Khalil-ee/MK.2-Flight-Controller/Altium/README

Schematic versions as we progress in this folder.
