Khalil-ee/MK.2-Flight-Controller/SDP_Project_Proposal_MGeorgiev_KMallory_KYacob_S2026.docx

MORGAN STATE UNIVERSITY

CLARENCE M. MITCHELL, JR. SCHOOL OF ENGINEERING

DEPARTMENT OF ELECTRICAL AND COMPUTER ENGINEERING

EEGR490

Senior Design Project Ι

Spring 2026

Project Proposal

Hybrid Flight Control System for Unmanned Aerial Vehicles

Project Members: Mitko Georgiev, Khalil Mallory, Kaleb Yacob

Project Advisor: Dr. Idris Somoye

2 April 2026

Table of Contents

Project Abstract .......................................................................................................................... 3

Identification & Significance of the Problem ............................................................................ 3

Technical Objectives ................................................................................................................. 4

Project Plan & Schedule ............................................................................................................ 4

Trade-Offs .................................................................................................................................. 8

Qualifications ............................................................................................................................. 10

Facilities/Equipment .................................................................................................................. 10

Budget ...................................................................................................................................... 11

References ................................................................................................................................ 13

Appendix .................................................................................................................................. 14

1. Project Abstract

This project presents the design and implementation of a custom flight controller that leverages a dual-processor architecture to achieve high-performance drone stabilization and advanced telemetry logging. The objective is to integrate an STM32 microcontroller with an Android smartphone via a USB interface to create a modular balance between real-time hardware reliability and high-level data processing. The methodology involves utilizing the STM32 for time-critical stabilization tasks, such as PID control loops, while the smartphone acts as the primary computer interface for real-time telemetry and a graphical user interface. Anticipated technical advancements include a scalable platform for detailed flight dynamics analysis, while economic benefits are realized through the upcycling of existing mobile hardware to replace expensive standalone companion computers. Ultimately, this research concludes that interfacing mobile computing power with dedicated microcontrollers provides a versatile and efficient alternative to traditional standalone flight controllers.

2. Identification & Significance of the Problem

The Problem: The Computational Bottleneck in Conventional UAVs

In the current landscape of Unmanned Aerial Vehicles (UAVs), there is a significant divide between low-cost hobbyist controllers and high-end industrial systems. Standard flight controllers, typically based on microcontrollers like the STM32, are highly efficient at real-time stabilization but lack the computational headroom to process high-level data. When developers need to add features like complex telemetry logging, high-resolution user interfaces, or cellular connectivity, they are forced to integrate expensive, power-hungry companion computers (such as a Raspberry Pi or NVIDIA Jetson). This adds significant weight, cost, and wiring complexity to the aircraft, creating a barrier for researchers and developers who need advanced functionality without the industrial price tag.

The Significance of the Research:

This research is significant because it explores a new hybrid architecture: the Smartphone-MCU system. Modern smartphones are among the most optimized pieces of hardware available, containing integrated GPS, high-speed cellular modems, high-resolution displays, and multi-core processors. However, they cannot directly fly a drone because they lack real-time precision—an Android OS might delay a motor command to process a background notification, which would cause a crash.

By using an STM32 to handle stabilization and the Android phone to handle telemetry and interfacing, this project addresses two major perspectives:

· The Economic Perspective-- It demonstrates a low-cost method to achieve high-end functionality by utilizing the capabilities of existing mobile hardware.

· The Engineering Perspective-- It solves the real-time latency issue by establishing a robust USB communication bridge between a non-real-time OS (Android) and a real-time microcontroller (STM32).

Background and Justification:

Current research in UAV telemetry often relies on proprietary radio links with limited bandwidth, which prevents the pilot from seeing detailed, real-time flight dynamics. Furthermore, data logging is usually restricted to small SD cards on the flight controller, making post-flight analysis cumbersome. By integrating a smartphone via USB, we leverage a high-speed data bus capable of logging thousands of data points per second directly to the phone’s flash storage. This justifies our research endeavor as a quest to create a more transparent, data-rich, and accessible flight control architecture.

Proposed Solution

Our work aims to provide a viable solution by developing a custom integrated circuit and software stack that bridges these two hardware worlds. By designing a system where the Android phone acts as the primary telemetry and command hub, we provide a unified solution for pilot interaction and data acquisition. This architecture eliminates the need for redundant sensors and expensive companion computers, ultimately proving that a high-performance, data-capable UAV can be built using a streamlined approach that is both cost-effective and technically superior to traditional standalone controllers.

3. Technical Objectives

Establish a Hardware Communication Bridge: Successfully implement the AOA protocol to enable high-speed data transfer between the STM32 and the Google Pixel 7a.

Real-Time Stabilization: Develop firmware to manage sensor fusion and PID control loops on the STM32 with millisecond precision.

Advanced Telemetry Logging: Utilize the smartphone's storage and processing power to log detailed flight dynamics that exceed the capacity of standard SD-card-based controllers.

Integrated User Interface: Create a functional Android application that provides the pilot with real-time flight statistics and command inputs.

4. Project Plan & Schedule

Project Summary

The overall goal is to create a modular architecture where the STM32 manages reflexes while the smartphone handles mission logic.

Spring Semester:

Week | Target Date | Task Description | Lead Member
1 | Feb 2 | Literature Review: USB HID vs. AOA Protocols for Android | Kaleb
2 | Feb 9 | Research and Select Optimal ESCs, Motors, and IMU Sensors | Mitko
3 | Feb 16 | Procurement: Ordering Frame, STM32 Board, and Electronics | Mitko
4 | Feb 23 | Hardware Assembly: Drone Frame and Motor Mounting | Mitko
5 | Mar 2 | Power System Setup: Soldering XT60 and PDB Connections | Khalil
6 | Mar 9 | Environment Setup: Android Studio and STM32CubeIDE Config | Kaleb
7 | Mar 16 | Spring Break (No Tasks Scheduled) | —
8 | Mar 23 | STM32 Firmware: Basic Peripheral Initialization (GPIO/PWM) | Khalil
9 | Mar 30 | Android App: Initialize USB Host/Accessory Permissions | Kaleb
10 | Apr 6 | PCB Schematic Design: STM32 to Phone USB Bridge | Mitko
11 | Apr 13 | Implementation: Establish USB Handshake (AOA Protocol) | Kaleb
12 | Apr 20 | Firmware: Reading IMU Raw Data via I2C | Khalil
13 | Apr 27 | Integration: Sending Raw Sensor Data to Android UI via USB | Team
14 | May 4 | Final Semester Presentation & Prototype Demonstration | Team

Fall Semester:

Week | Target Date | Task Description | Lead Member
15 | Aug 31 | Post-Summer Hardware Audit & Firmware Refactoring | Mitko
16 | Sep 7 | Implement PID Control Loops for Roll and Pitch | Khalil
17 | Sep 14 | Android App: Real-Time Telemetry Dashboard UI Finalization | Kaleb
18 | Sep 21 | Tuning Session: Manual Prop-off Vibration Analysis | Mitko
19 | Sep 28 | Implement Failsafe Protocols (USB Disconnect Auto-Land) | Kaleb
20 | Oct 5 | Integrate Yaw Control and Heading Hold Algorithms | Khalil
21 | Oct 12 | Mid-Semester Review: Bench Testing & Safety Verification | Team
22 | Oct 19 | Optimization: 5G/LTE Telemetry Data Stream Testing | Kaleb
23 | Oct 26 | PCB Revision 2: Finalizing Integrated Shielding | Mitko
24 | Nov 2 | Initial Flight Tests: Tethered Leveling and Hover | Khalil
25 | Nov 9 | Data Analysis: Comparing Onboard Logging vs. App Data | Kaleb
26 | Nov 16 | Free Flight Calibration & Endurance Testing | Mitko
27 | Nov 23 | Thanksgiving Break (No Tasks Scheduled) | —
28 | Nov 30 | Final Project Video & Technical Documentation Assembly | Team
29 | Dec 7 | Senior Design Expo: Final Flight Demonstration | Team

5. Trade-Offs

Trade Off and Opportunity Cost

Question: Which microcontroller is better for real-time drone stabilization?

Trade Offs:

1. STM32 Nucleo-F446RE
2. Arduino Uno

Processing Speed:

- STM32 Nucleo-F446RE: 180 MHz clock speed with ARM Cortex-M4 core
- Arduino Uno: 16 MHz clock speed with AVR core

The flight controller requires high-frequency PID loops to maintain stability. The STM32 provides significantly more processing headroom for real-time interrupts and sensor fusion.

Digital I/O and Peripherals:

- STM32 Nucleo-F446RE: Multiple I2C, SPI, and high-speed UART ports
- Arduino Uno: 1 I2C port, 1 SPI port, 1 hardware Serial port

Our project requires simultaneous communication with an IMU via I2C and a Google Pixel 7a via USB. The STM32 offers the necessary independent hardware peripherals to manage these connections without data bottlenecks.

USB Connectivity:

- STM32 Nucleo-F446RE: Supports USB 2.0 Full Speed with specialized drivers for AOA
- Arduino Uno: Limited to serial-to-USB conversion

The STM32 can function as a USB Host, which is essential for the Android Open Accessory (AOA) protocol required to interface with the Google Pixel 7a.

Price:

- STM32 Nucleo-F446RE: $21.76
- Arduino Uno: $19.99–$23.00

The STM32 Nucleo is more cost-effective while offering vastly superior technical specifications.

Question: Which companion computer/interface is most effective for advanced telemetry?

Trade Offs:

1. Google Pixel 7a (Integrated Smartphone)
2. Raspberry Pi 4 (Single Board Computer)

Integrated Sensors and Connectivity:

- Google Pixel 7a: Built-in 5G/LTE, GPS, Barometer, IMU, and high-resolution camera
- Raspberry Pi 4: No integrated sensors or cellular connectivity; requires external modules

The Google Pixel 7a provides a wide suite of pre-calibrated sensors and native 5G connectivity, which is the industry expectation for modern autonomous drones.

Display and User Interface:

- Google Pixel 7a: Integrated OLED touchscreen for real-time telemetry visualization
- Raspberry Pi 4: Requires an external HDMI monitor or remote network connection

The smartphone provides an immediate, portable user interface for the pilot to monitor flight dynamics and log data directly to local storage.

Price:

- Google Pixel 7a (Unlocked/Fair): $129.99
- Raspberry Pi 4 (4GB) + Modules: ~$150.00+ after adding GPS, LTE, and camera modules

The Google Pixel 7a is more cost-effective as it consolidates several expensive components into one unit.

Conclusion: The selection of the STM32 Nucleo-F446RE is superior because it provides the high-speed real-time processing and peripheral support necessary for flight stability at a lower price point than an Arduino Uno. Furthermore, the Google Pixel 7a is the more effective choice for a companion computer because it natively offers 5G/LTE connectivity and a full sensor suite, providing a better user-friendly interface and advanced telemetry capabilities compared to a modular SBC. Therefore, the STM32 board and Google Pixel 7a are the best options for our hybrid flight controller project.

6. Qualifications

Kaleb Yacob: Responsible for Android application development, USB protocol implementation, and high-level systems integration. Expertise in software environments and data processing.

Mitko Georgiev: Responsible for physical hardware assembly, power distribution systems, and PCB design. Expertise in component procurement and mechanical integration.

Khalil Mallory: Responsible for STM32 firmware, PID control tuning, and sensor fusion algorithms. Expertise in embedded C programming.

7. Facilities/Equipment

The project will primarily utilize the Electrical and Computer Engineering Senior Design Lab for soldering and hardware testing. Software development will be performed using Android Studio and STM32CubeIDE. Additional manufacturing will utilize the Ender 3 V3 3D Printer for custom component mounts.

8. Budget

Category | Item Description | Vendor | Total (Gross)
Computing | Google Pixel 7a (128GB Unlocked) | eBay | $137.79
| STM32 Nucleo-F446RE Dev Board | STMicro | $21.76
| STM32F401 Evaluation Board | DigiKey | $53.39
Propulsion | QWinOut A2212 1400KV Brushless Motors (4 Pcs) | Amazon | $32.88
| 1045 Propeller Blades (4 Pcs) | Amazon | $7.44
| Propeller Adapter Holders (5 Pcs) | Amazon | $9.53
Power | TATTU 1300mAh 11.1V Lipo Battery | Alibaba | $19.50*
| Servo Extension Lead Wire Cables | Alibaba | $32.23
| 3.5mm Banana Connector Extension Wires | Alibaba | $10.59
Structure | Refurbished Creality Ender 3 V3 KE 3D Printer | eBay | $170.29
| 500mm Square Carbon Fiber Tubes (2 Pcs) | Alibaba | $29.47
| 16.5" Aluminum Square Tubes (4 Pcs) | Amazon | $10.59
| PETG+ Filament (Blue & Orange) | Micro Center | $33.95
Hardware | M3 Brass Standoffs & Spacers Kit | Amazon | $15.89
| M3 Stainless Steel Screw Assortment | Amazon | $9.53
| Miscellaneous Screws & Allen Bolts | Alibaba | $2.66
Tools/Misc | ST-Link V2 Emulator/Programmer | Amazon | $6.35
| USB Type C to TTL Serial Adapter | Amazon | $10.59
| 1580 Test Breadboard | Micro Center | $22.99
| Desiccant Packs & Magnetic Parts Tray | Micro Center | $12.97
Grand Total | | | $650.38

9. References

- Dantsker, O. D., Mancuso, R., Selig, M. S., & Caccamo, M. (2014). High-frequency sensor data acquisition system (SDAC) for flight control and aerodynamic data collection. AIAA Guidance, Navigation, and Control Conference. https://doi.org/10.2514/6.2014-0612 (https://cs-people.bu.edu/rmancuso/files/papers/hfreq_sdac_aiaa14.pdf)
- Kadam, S., & Ruikar, S. (2024). Designing flight controller of quadcopter using Stm32 microcontroller. International Journal of Innovative Research in Technology (IJIRT), 11(3). https://ijirt.org/publishedpaper/IJIRT167412_PAPER.pdf
- Tsai, S.-E., Yang, S.-M., & Sun, W.-C. (2025). The study on real-time RRT-based path planning for UAVs using a STM32 microcontroller. Electronics, 14(24), 4901. https://doi.org/10.3390/electronics14244901
- Yang, H., Bian, H., Li, B., & Zhao, X. (2022). A low-cost and ultralight unmanned aerial vehicle-borne multicamera imaging system based on smartphones. Mathematical Problems in Engineering, 2022(5), 1-15. https://doi.org/10.1155/2022/8524400 (https://www.google.com/search?q=https://doi.org/10.1155/2022/8524400)

10. Appendix

Resumes:

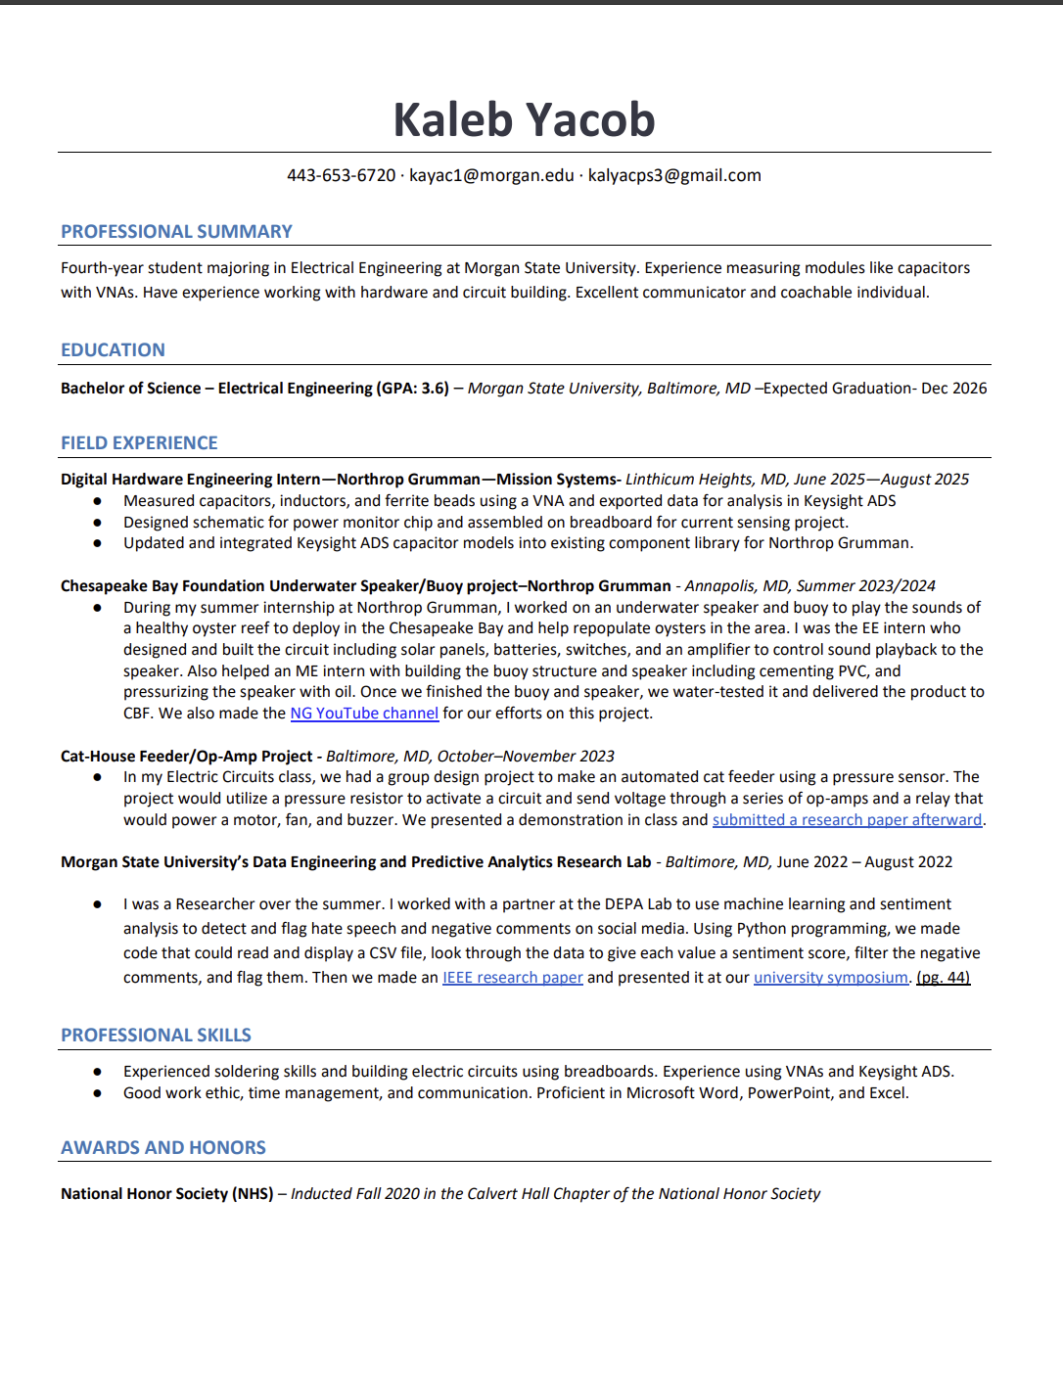
[picture p1: figure]
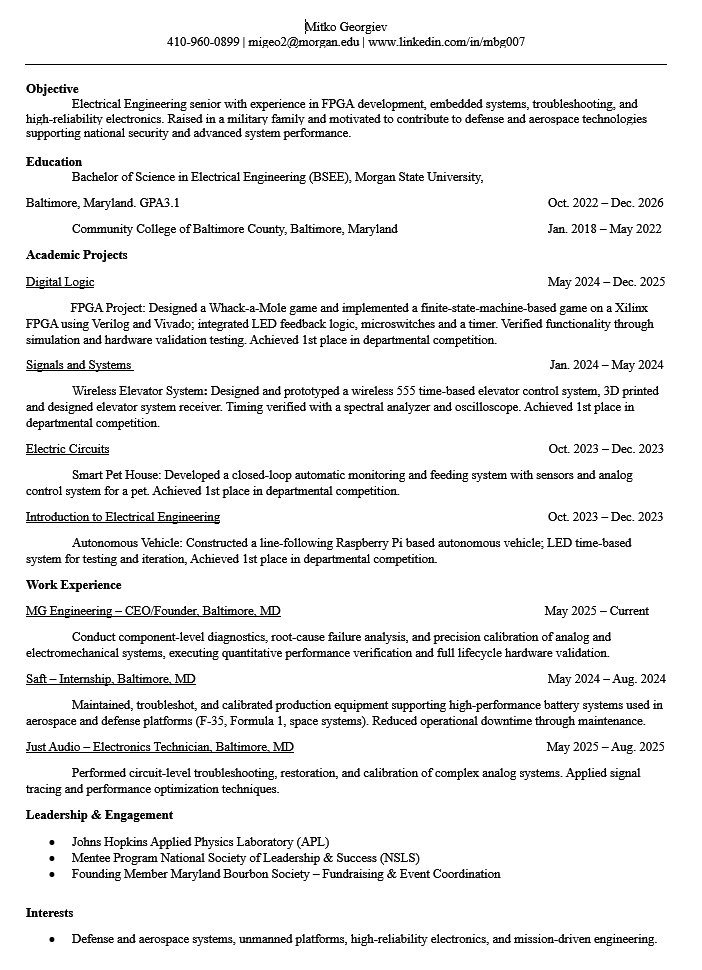
[picture p2: figure]
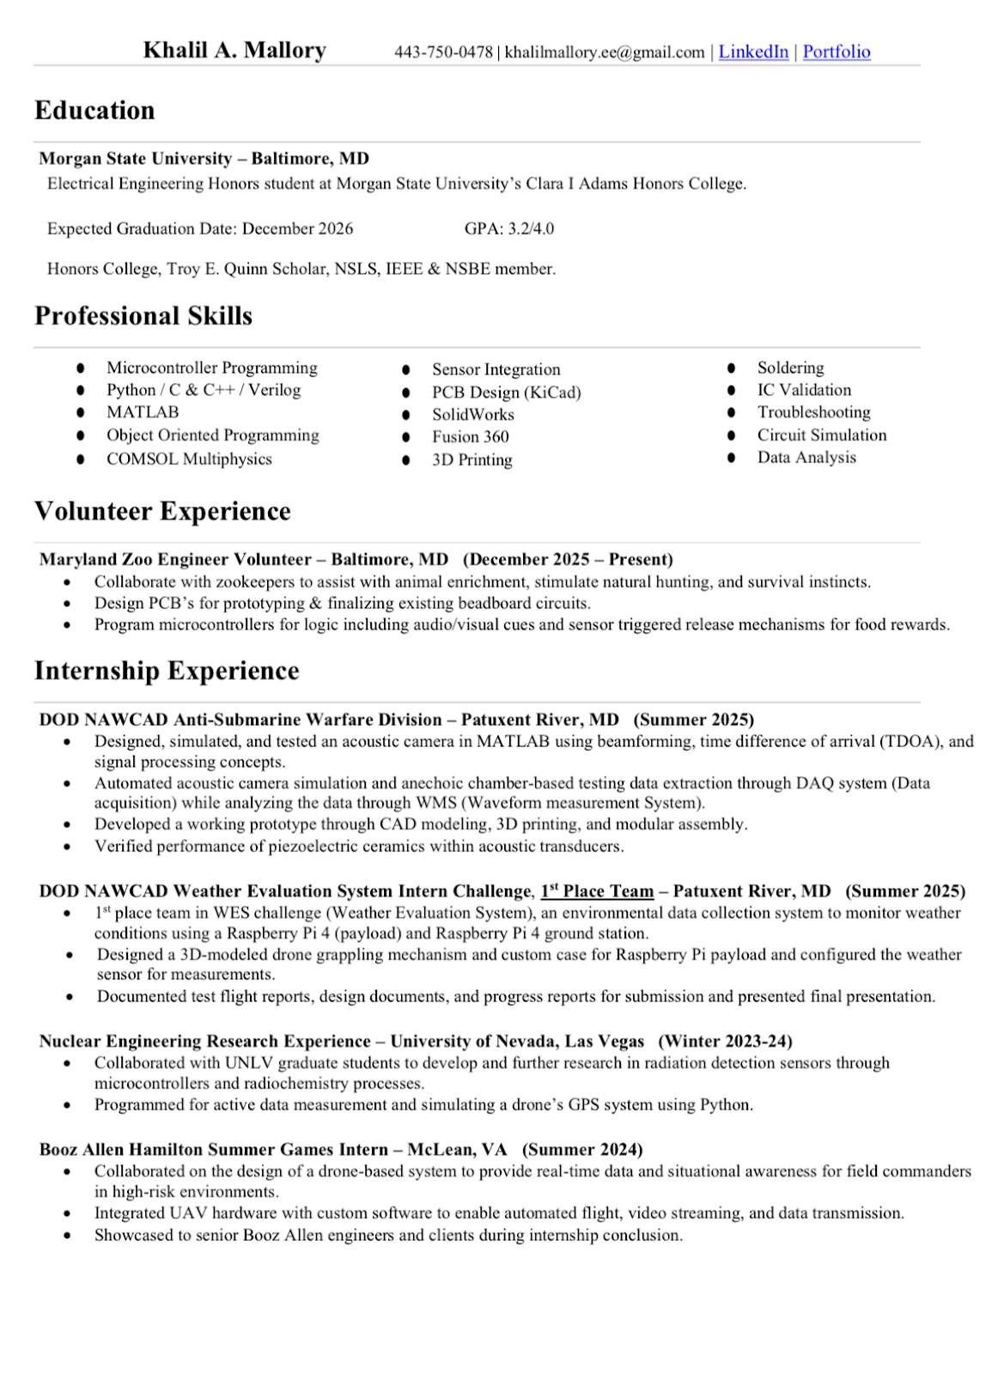
[picture p3: figure]
