Khalil-ee/MK.2-Flight-Controller/MK2_Gantt_Chart.png

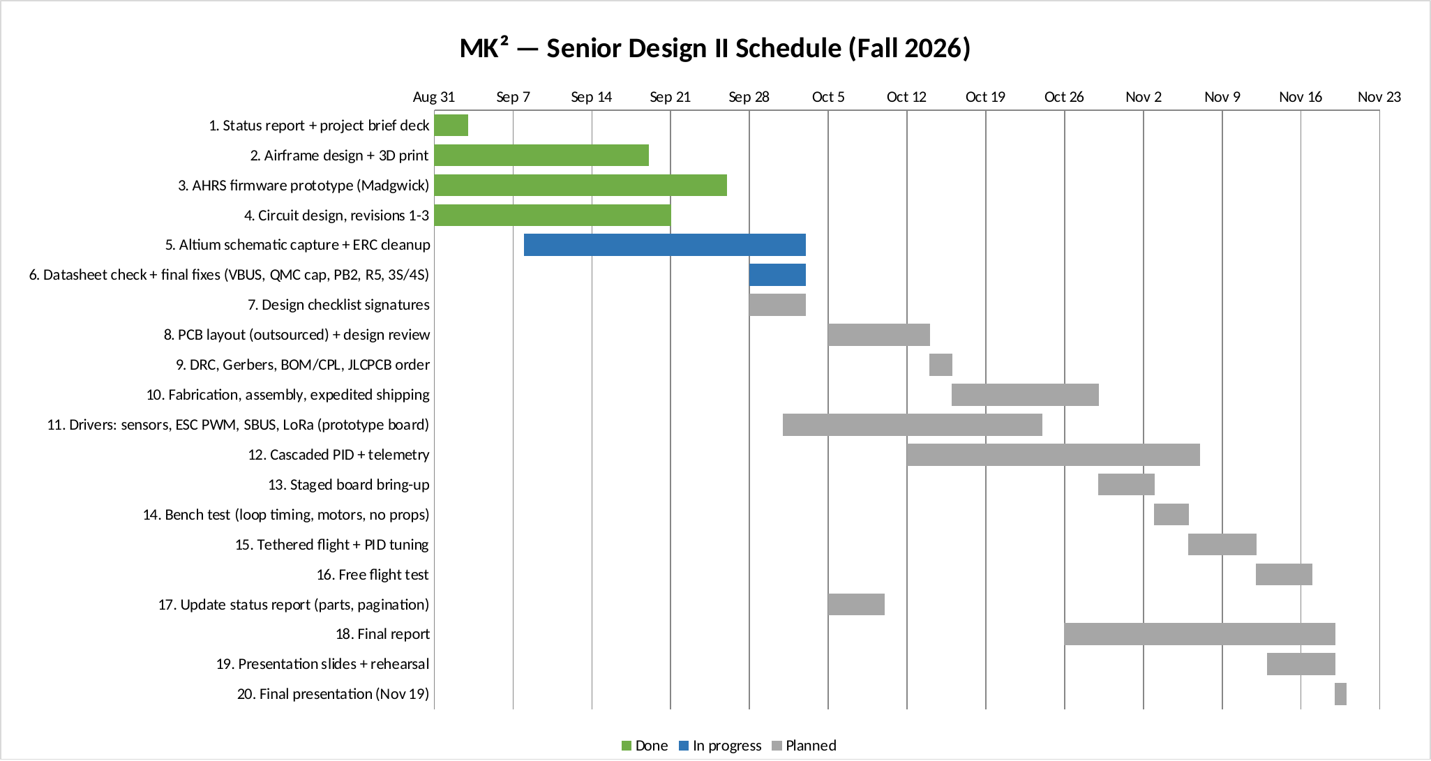
MK2_Gantt_Chart.png
