Khalil-ee/MK.2-Flight-Controller/Altium/Schematic v3.1/KKM_Drone_BOM.xlsx

Ref Des | Part / Value | Description / Function | Sheet | Notes
Battery Input, Protection, 5.2V Buck
Q1 | DMP3098L-7 (P-MOSFET) | Reverse-polarity protection — blocks current if battery is plugged in backwards | Battery Input
R1 | 100k | Gate pull-down for Q1, holds it off until VBAT is present | Battery Input
D1 | SMBJ15A (TVS) | Clamps voltage spikes on the battery line | Battery Input | 3S only — see note
C1 | 470uF/35V | Bulk input capacitance, smooths battery ripple | Battery Input
C2, C6 | 100nF | Local decoupling on VIN and SW nodes | Battery Input
C3 | 10uF/50V | Additional input filtering at U2 VIN pin | Battery Input
U2 | MP1584EN-LF-Z | Buck converter IC — steps battery voltage down to 5.2V | Battery Input | NRND per datasheet; MP2338 is successor
R_FREQ | 200k | Sets buck switching frequency (~485kHz) | Battery Input
R_COMP, C_COMP | 100k, 150pF | Compensation network for buck control loop stability | Battery Input
C_BST | 100nF | Bootstrap capacitor, powers U2 internal high-side gate driver | Battery Input
L1 | 15uH, 3A sat | Buck converter output inductor | Battery Input
D2 | SS34-E3/9AT (Schottky) | Buck catch / freewheeling diode | Battery Input
C5 | 22uF/25V (Low ESR) | Buck output filter capacitor | Battery Input
R5, R3 | 54.9k, 10k | Feedback divider — sets 5.2V buck output | Battery Input | R5 corrected from 55k
USB-C (Power + DFU), Diode-OR, 3.3V LDO
J8 | TYPE-C-31-M-12 | USB-C receptacle — power and DFU firmware entry | USB-C / LDO
R_CC1, R_CC2 | 5.1k | CC pull-downs — advertises sink device to USB-C host | USB-C / LDO
U_ESD | USBLC6-2P6 | ESD protection for USB data and VBUS lines | USB-C / LDO | VBUS port label pending
D3, D4 | SS34-E3/9AT | Diode-OR — lets USB or battery power the board, whichever is higher | USB-C / LDO
C_VBUS | 10uF | Filters incoming USB 5V | USB-C / LDO
U3 | AMS1117-3.3 | Linear regulator — makes 3.3V from +5V_BATT | USB-C / LDO
C_LDO_IN, C_LDO_OUT | 10uF, 22uF | LDO input / output filtering | USB-C / LDO
C_VDD1-4 | 100nF (x4) | Decoupling for the 3.3V rail | USB-C / LDO
C_BULK | 2.2uF | Extra 3.3V bulk capacitance | USB-C / LDO
SW_BOOT, SW_RST | B3U-1000P-B | Tactile buttons for BOOT0 and NRST — DFU entry | USB-C / LDO
STM32F446RET6 Core
U1 | STM32F446RET6 | Main flight controller microcontroller (LQFP-64) | MCU Core
MCU Support Circuits
R_NRST, C_NRST | 10k, 100nF | Reset pull-up and debounce for NRST | MCU Support
R_BOOT | 10k | Pull-down for BOOT0 — normal boot from flash by default | MCU Support
C_VCAP | 4.7uF X5R | Required cap on MCU internal core regulator (VCAP) | MCU Support
FB2 | 600R ferrite bead | Filters noise between +3.3V and VDDA (analog supply) | MCU Support
C_VDDA1, C_VDDA2 | 1uF, 10nF | VDDA filtering | MCU Support
Y1 | 24MHz crystal (XRCGB24M000F3M00R0) | Main clock source for the MCU | MCU Support
C7, C8 | 6.8pF | Crystal load capacitors | MCU Support
I2C Sensors A - IMU and Magnetometer
U4 | MPU-6050 | 6-axis IMU (accel + gyro) — core sensor for flight stabilization | IMU / Mag
C_CPOUT | 2.2nF | MPU-6050 charge pump filter cap | IMU / Mag
C_REGOUT | 0.1uF | MPU-6050 internal regulator filter cap | IMU / Mag
C_VLOGIC | 10nF | Filters MPU-6050 digital I/O supply | IMU / Mag | VLOGIC now tied direct to +3.3V
U5 | QMC5883L | 3-axis magnetometer — compass / heading reference | IMU / Mag
C_RES | 4.7uF | Reservoir cap on QMC5883L pin 10 (C1) | IMU / Mag
C_SR | 2.2nF (was 0.22uF) | QMC5883L set/reset capacitor, between SETP and SETC | IMU / Mag | Needs value + rewire fix
CAP_BYPASS | 0.1uF | QMC5883L supply bypass | IMU / Mag
R2, R4 | 2.2k | I2C bus pull-ups for SDA/SCL | IMU / Mag
I2C Sensors B - Barometer, Current Monitor, Battery Sense
U6 | BMP280 | Barometric pressure sensor — used for altitude | Baro / INA / Sense
C_BMP1, C_BMP2 | 100nF | BMP280 supply decoupling | Baro / INA / Sense
C_CS | 100nF | Filtering on CS/address-strap line | Baro / INA / Sense
U7 | INA219AIDCNT | Current/voltage monitor on +5V_SYS rail | Baro / INA / Sense
R_SHUNT | 0.1R | Current sense shunt resistor for the INA219 | Baro / INA / Sense
C_INA | 100nF | INA219 supply decoupling | Baro / INA / Sense
R6, R7 | 33k, 10k | Battery voltage divider — scales VBAT for MCU ADC | Baro / INA / Sense
C14 | 100nF | Filter cap on ADC sense line | Baro / INA / Sense
RC Input, Status LED, SWD Header
Q2 | MMBT3904 (NPN) | Inverts SBUS signal (idle-low to idle-high) for MCU UART | RC / LED / SWD
R20, R21 | 10k | Base and pull-up resistors for Q2 inverter | RC / LED / SWD
U10 | WS2812B | Addressable RGB status LED | RC / LED / SWD
R25 | 100R | Series resistor damping the LED data line | RC / LED / SWD
D5 | 1N4148 | Drops LED supply so data-high matches MCU 3.3V logic | RC / LED / SWD
C22 | 100nF | LED supply decoupling | RC / LED / SWD
J_SWD | SWD header | Programming/debug connector for flashing firmware | RC / LED / SWD
External Connectors
J4 | S3B-XH-A(LF)(SN) | RC receiver connector (SBUS in) | External Connectors
J5 | S4B-XH-A(LF)(SN) | GPS module connector | External Connectors
J7 | TSW-107-05-G-S | LoRa telemetry module socket | External Connectors
C_LORA | 100nF | LoRa module supply decoupling | External Connectors
J_M1-J_M4 | S3B-XH-A(LF)(SN) | ESC connectors, one per motor | External Connectors | Pin 2 (BEC) left unconnected on all 4
J_BAT | XT30PB | Battery input connector | External Connectors
