Khalil-ee/MK.2-Flight-Controller/References/Nucleo Cubemx setup for IDE startup.txt

cubemx
board selector > choose board
start project > project manager > enter project name > set toolchain to stm32cubeide > choose directory
pinout and configuration > select pins for your task 
generate code
should prompt you to allow it to open the project > open project
click drop down mennu of the file name > core > src > main.c > double click main
code 
click hammer to check for errors
run
