Khalil-ee/MK.2-Flight-Controller/Altium/Schematic v3.1/Schematic v3.2.pdf

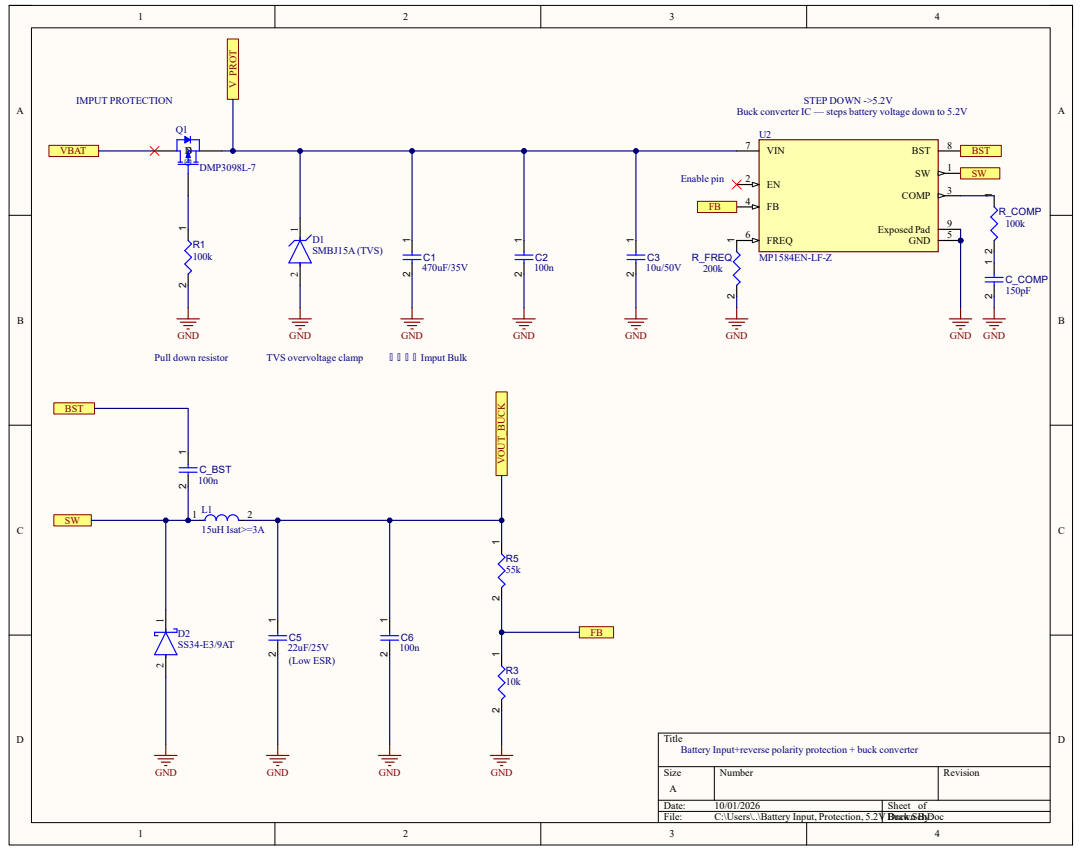
[picture p5: page 1]

Buck converter IC — steps battery voltage down to 5.2V

Title
Battery Input+reverse polarity protection + buck converter

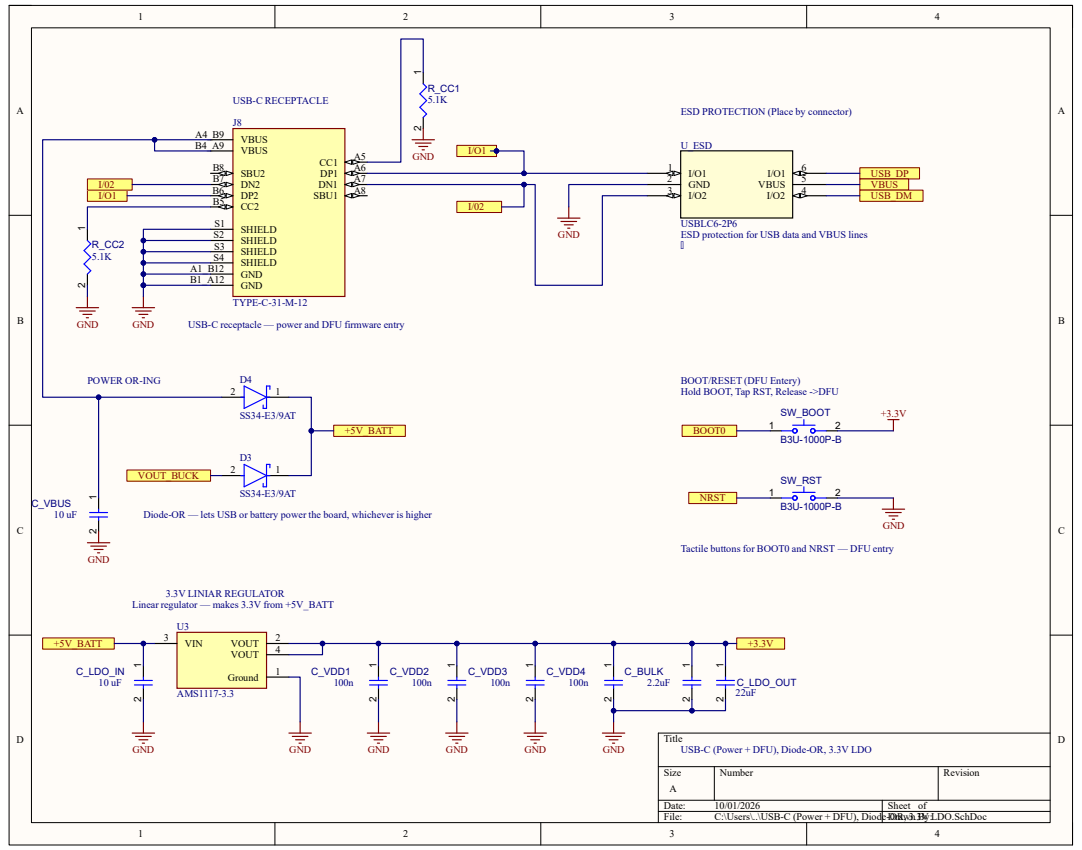
[picture p6: page 2]
Size; Number; Revision; File:; C:\Users\..\USB-C (Power + DFU), Diode-OR, 3.3V LDO.SchDoc Drawn By:; VIN 3; VOUT; Ground; AMS1117-3.3; +5V_BATT; GND ¹ ²; C_LDO_IN; GND; C_VDD1; C_VDD2; C_VDD3; C_VDD4; C_BULK; 3.3V LINIAR REGULATOR; USB-C RECEPTACLE; SW_BOOT; SW_RST; BOOT0; NRST; C_LDO_OUT; SBU1; VBUS A4_B9 VBUS B4_A9; SBU2 B8 DN2 B7 DP2 B6 CC2 B5; SHIELD S1 SHIELD S2 SHIELD S3 SHIELD S4 GND A1_B12 GND B1_A12; TYPE-C-31-M-12; I/O1 1 GND 2 I/O2 3; VBUS; U_ESD; USB_DP VBUS USB_DM; GND ² ¹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

ESD PROTECTION (Place by connector)

USBLC6-2P6
ESD protection for USB data and VBUS lines

USB-C receptacle — power and DFU firmware entry

POWER OR-ING

BOOT/RESET (DFU Entery)
Hold BOOT, Tap RST, Release ->DFU

Diode-OR — lets USB or battery power the board, whichever is higher

Tactile buttons for BOOT0 and NRST — DFU entry

Linear regulator — makes 3.3V from +5V_BATT

Title
USB-C (Power + DFU), Diode-OR, 3.3V LDO

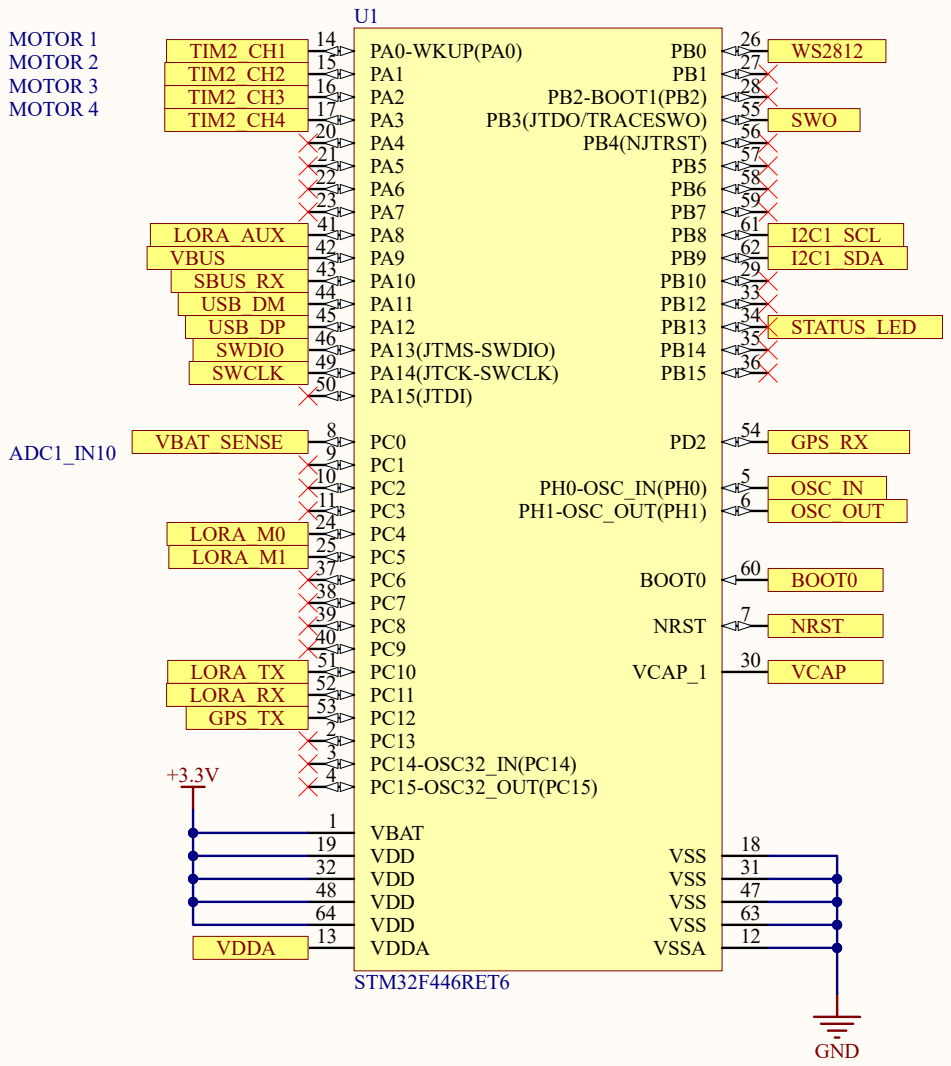
[picture p7: page 3]
Title; Size; Number; Revision A; File:; C:\Users\..\STM32F446RET6 Core.SchDocDrawn By:; PA0-WKUP(PA0) 14 PA1 15 PA2 16 PA3 17; PB2-BOOT1(PB2); PC14-OSC32_IN(PC14); PC15-OSC32_OUT(PC15); PA8 41 PA9 42 PA10 43 PA11 44 PA12 45 PA13(JTMS-SWDIO) 46 PA14(JTCK-SWCLK) 49; PH0-OSC_IN(PH0); PA15(JTDI) 50; PB3(JTDO/TRACESWO); PB4(NJTRST); PH1-OSC_OUT(PH1); BOOT0; NRST; VBAT; VSSA; 12 VDDA 13; VSS; 18 VDD 19; VCAP_1; 31 VDD 32; 47 VDD 48; 63 VDD 64; STM32F446RET6; TIM2_CH1 TIM2_CH2 TIM2_CH3 TIM2_CH4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

+3.3V1 2

# C_NRST ² ¹

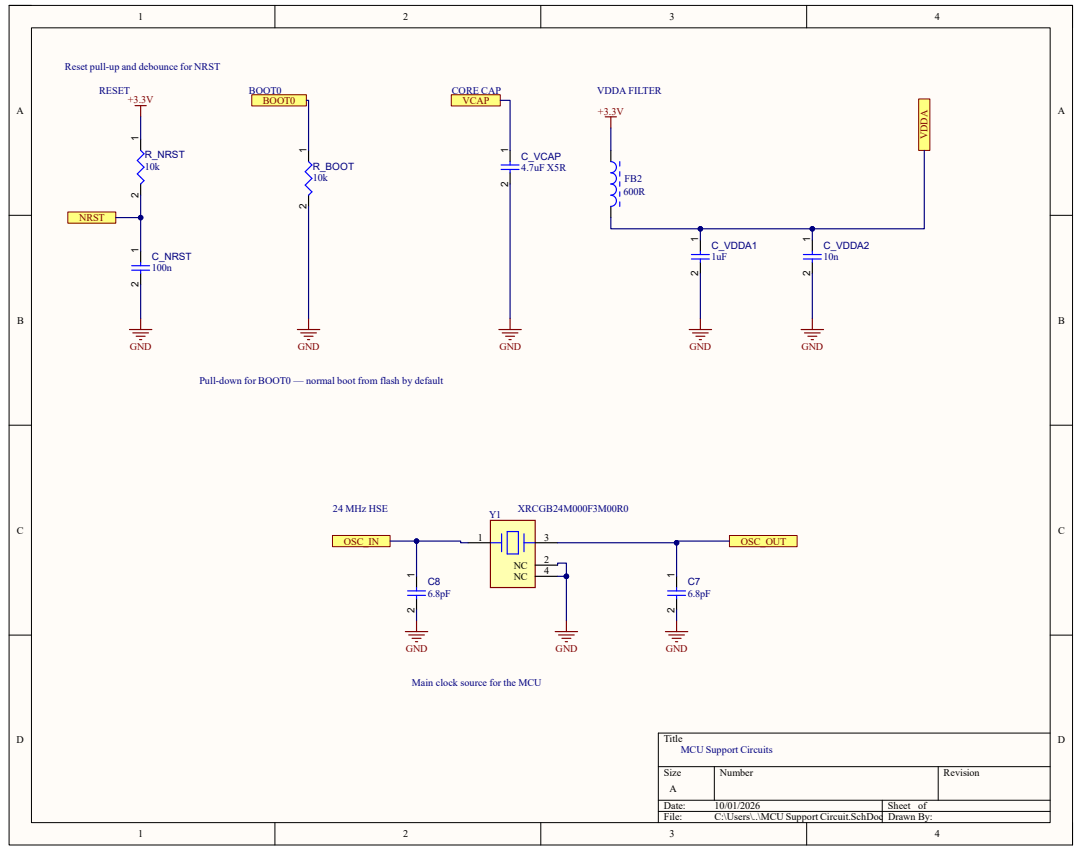
[picture p8: page 4]
Size; Number; Revision; File:; C:\Users\..\MCU Support Circuit.SchDoc; Drawn By:; RESET; R_NRST; NRST; GND; BOOT0 BOOT0 2 1; R_BOOT; CORE CAP VCAP 1 2; C_VCAP; VDDA FILTER; C_VDDA1; C_VDDA2; VDDA; XRCGB24M000F3M00R0; OSC_IN; OSC_OUT 1 2; 24 MHz HSE

Reset pull-up and debounce for NRST

Pull-down for BOOT0 — normal boot from flash by default

Main clock source for the MCU

Title
MCU Support Circuits

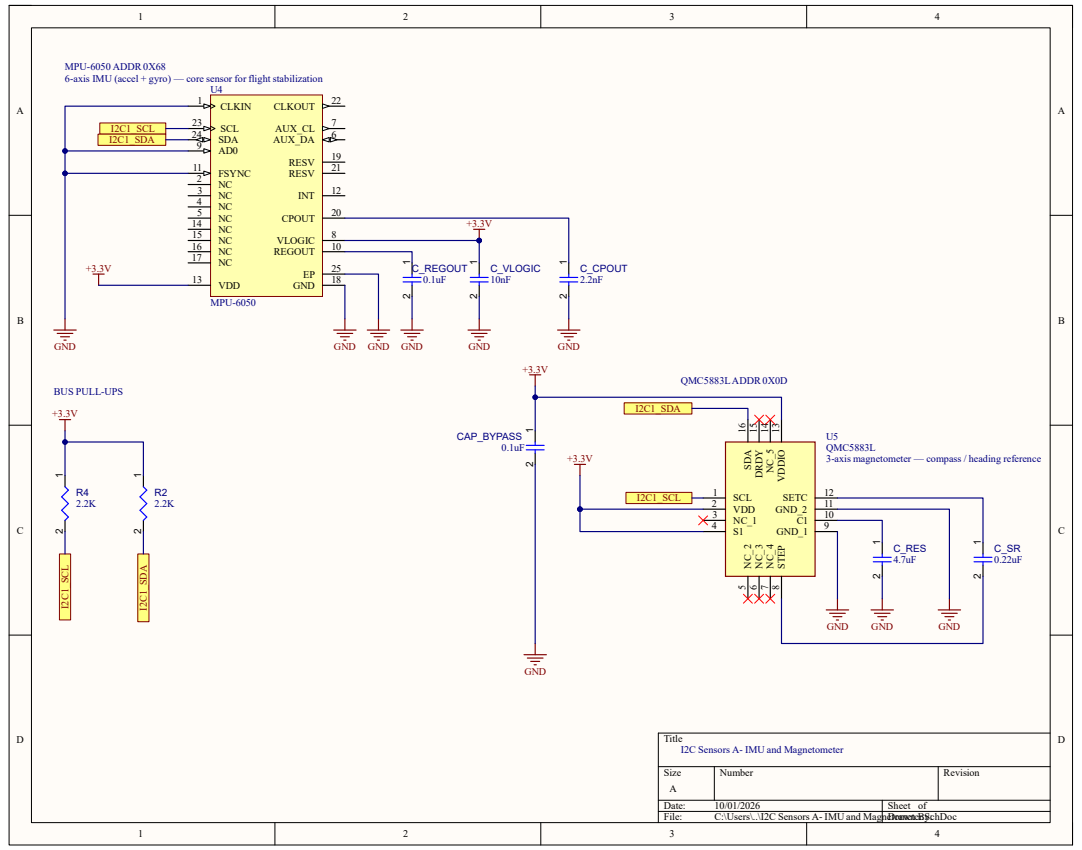
[picture p9: page 5]
Size; Number; Revision; File:; C:\Users\..\I2C Sensors A- IMU and Magnetometer.SchDoc Drawn By:; SCL 1 VDD 2 NC_1 3; 6 NC_4 7 STEP; GND_1; 10 GND_2; 11 SETC; 12 VDDIO ¹³ NC_5 14 DRDY ¹⁵ SDA ¹⁶; QMC5883L ADDR 0X0D; R2 I2C¹_SCL; I2C¹_SDA; CLKIN 1; AUX_DA; AUX_CL; VLOGIC; REGOUT; FSYNC 11; INT; VDD 13; GND; RESV; CPOUT; CLKOUT; SCL 23 SDA 24; MPU-6050; C_CPOUT ¹ 2 0.1uF; C_REGOUT; I2C1_SCL I2C1_SDA; I2C1_SCL; I2C1_SDA; C_RES; GND 1 2; CAP_BYPASS; C_VLOGIC

MPU-6050 ADDR 0X68
6-axis IMU (accel + gyro) — core sensor for flight stabilization

BUS PULL-UPS

QMC5883L
3-axis magnetometer — compass / heading reference

Title
I2C Sensors A- IMU and Magnetometer

# GND¹ ²

+3.3V1 2

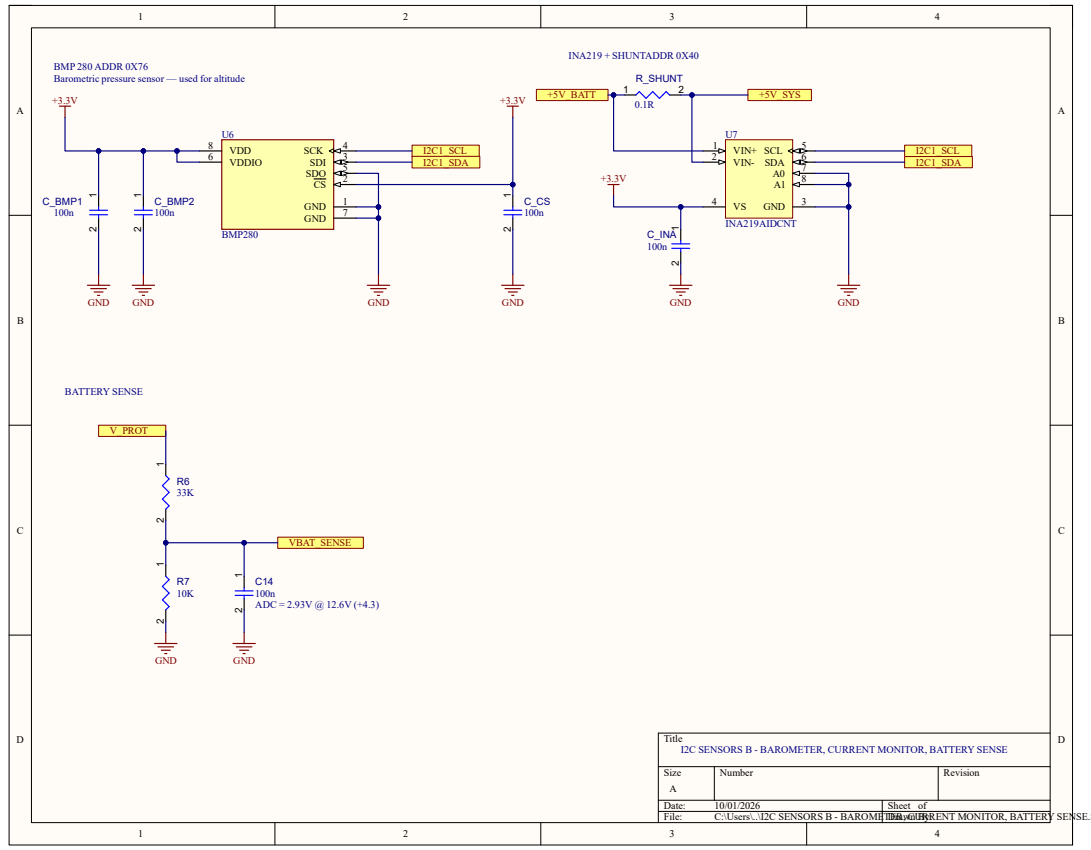
[picture p10: page 6]
Size; Number; Revision; File:; C:\Users\..\I2C SENSORS B - BAROMETER, CURRENT MONITOR, BATTERY SENSE.SchDoc Drawn By:; VDD 8 VDDIO 6; SCK; SDI; SDO; GND; BMP280; I2C1_SCL I2C1_SDA; C_BMP2; INA219 + SHUNTADDR 0X40; VIN+ 1 VIN- 2; SCL; SDA; INA219AIDCNT; I2C1_SCL I2C1_SDA 1 2; C_INA; R_SHUNT; +5V_BATT; +5V_SYS; BATTERY SENSE 2 1; V_PROT; VBAT_SENSE; ADC = 2.93V @ 12.6V (+4.3); C_BMP1

BMP 280 ADDR 0X76
Barometric pressure sensor — used for altitude

Title
I2C SENSORS B - BAROMETER, CURRENT MONITOR, BATTERY SENSE

1 2 3

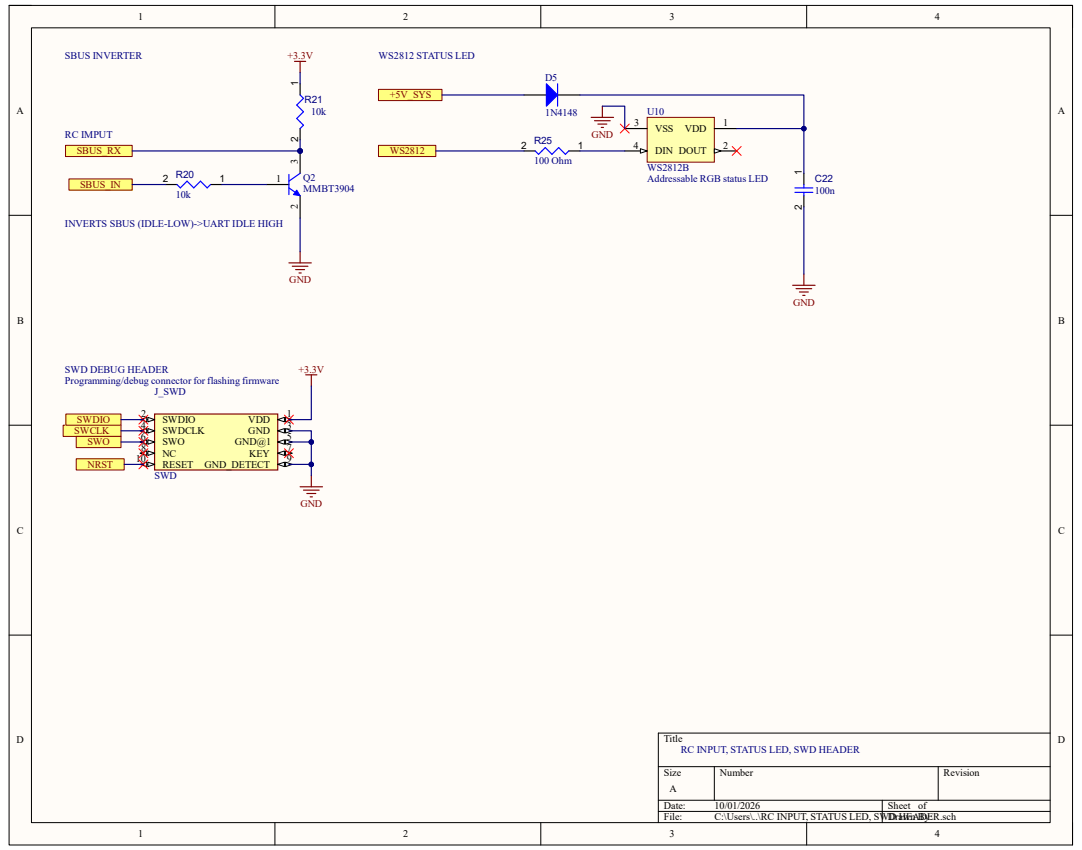
[picture p11: page 7]
Size; Number; Revision; File:; C:\Users\..\RC INPUT, STATUS LED, SWD HEADER.sch Drawn By:; MMBT3904 ² ¹; GND; SBUS_IN; SBUS_RX; RC IMPUT; SBUS INVERTER; VDD; DOUT; VSS 3; DIN 4; +5V_SYS; 100 Ohm; SWDIO 2 SWDCLK 4 SWO 6 NC 8 RESET 10; GND@1; KEY; GND_DETECT; J_SWD; SWD; SWCLK; SWDIO; NRST; WS2812 STATUS LED; SWO

Addressable RGB status LED

INVERTS SBUS (IDLE-LOW)->UART IDLE HIGH

SWD DEBUG HEADER
Programming/debug connector for flashing firmware

Title
RC INPUT, STATUS LED, SWD HEADER

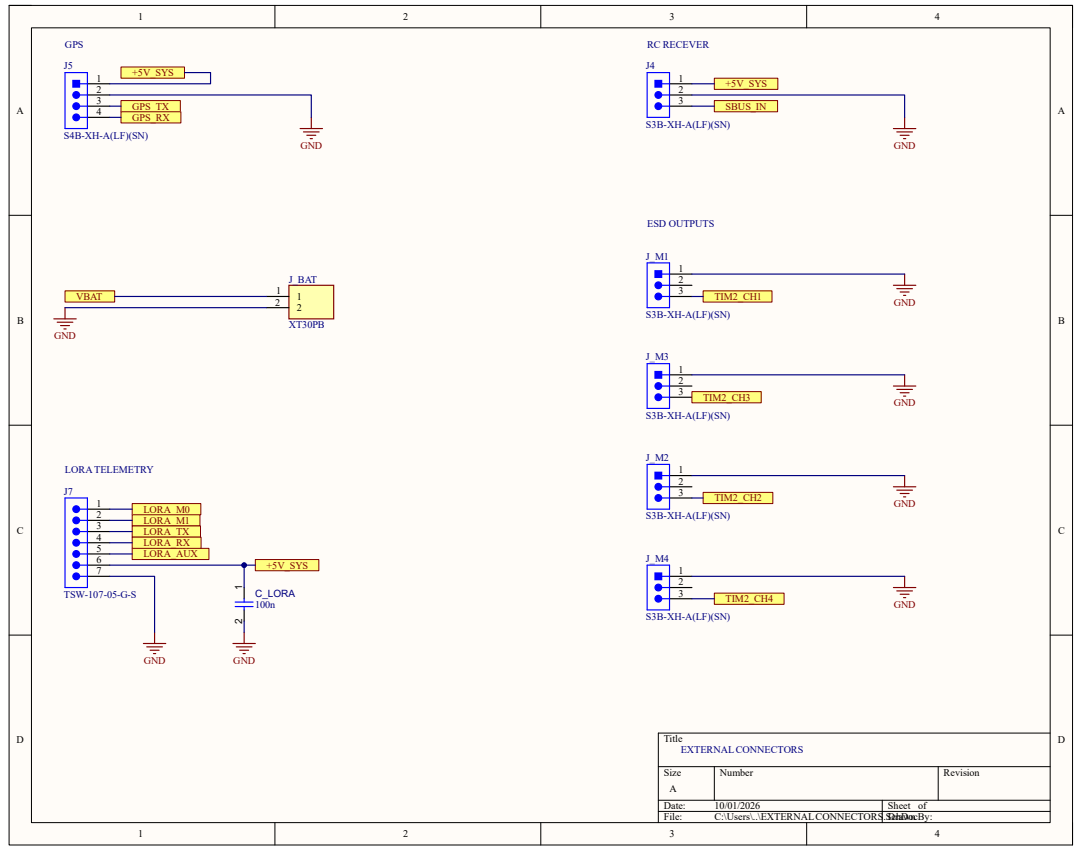
[picture p12: page 8]
Title; Size; Number; Revision; File:; C:\Users\..\EXTERNAL CONNECTORS.SchDoc Drawn By:; GPS_TX GPS_RX; GND; GPS; RC RECEVER; +5V_SYS; SBUS_IN; TIM2_CH1; TIM2_CH3; TIM2_CH4; TIM2_CH2 1; TSW-107-05-G-S; C_LORA; LORA_AUX; LORA_M0 LORA_M1 LORA_TX LORA_RX; LORA TELEMETRY; ESD OUTPUTS; EXTERNAL CONNECTORS; J_BAT; VBAT
