Khalil-ee/MK.2-Flight-Controller/Altium/Schematic v3/Schematic v3.pdf

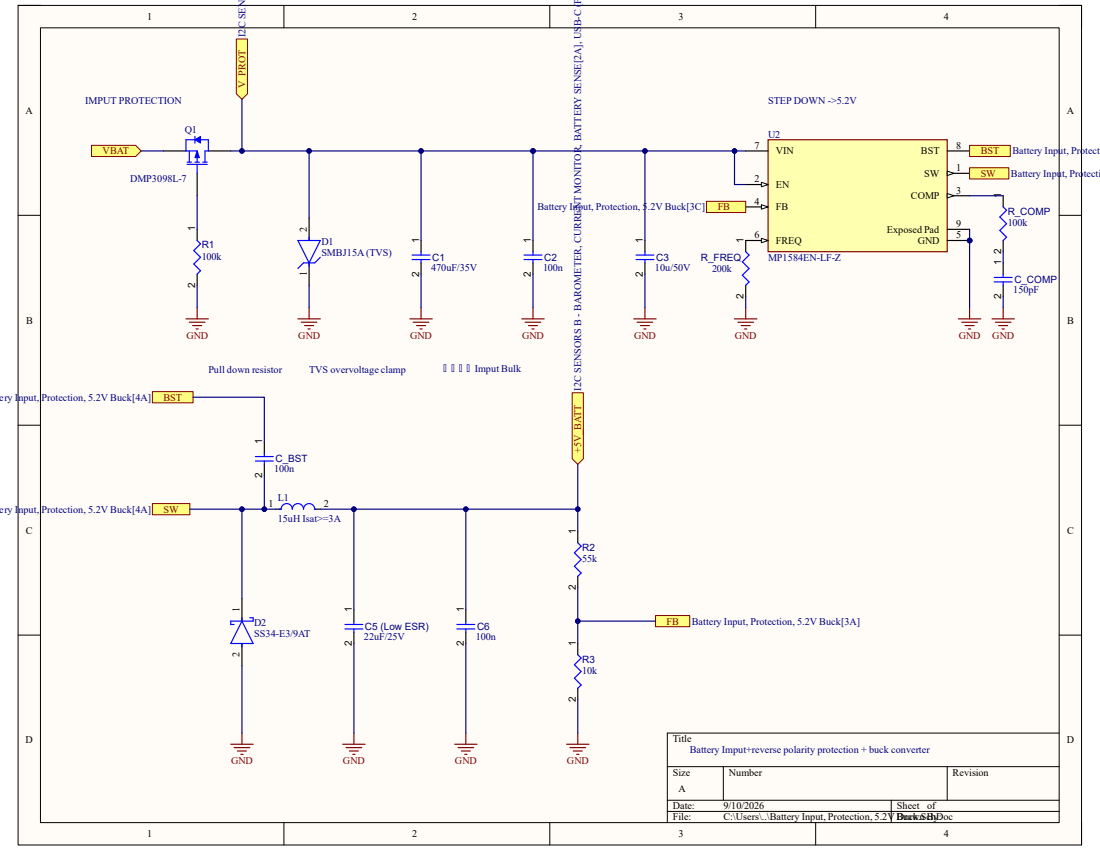
[picture p20: page 1]

BST Battery Input, Protection, 5.2V Buck[1B]

Battery Input, Protection, 5.2V Buck[3C] FB

Battery Input, Protection, 5.2V Buck[4A] SW

Title
Battery Imput+reverse polarity protection + buck converter

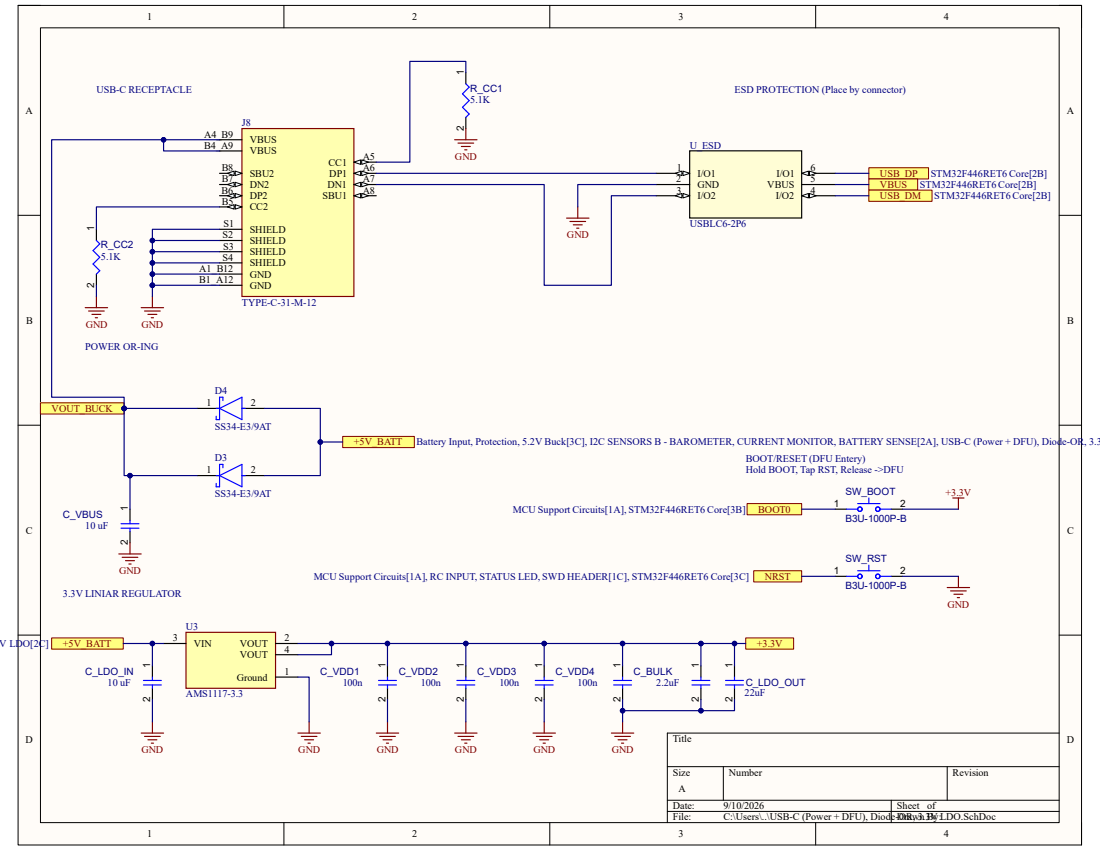
[picture p21: page 2]
Title; Size; Number; Revision; File:; C:\Users\..\USB-C (Power + DFU), Diode-OR, 3.3V LDO.SchDoc Drawn By:; VIN 3; VOUT; Ground; AMS1117-3.3; +5V_BATT; GND ¹ ²; C_LDO_IN; GND; C_VDD1; C_VDD2; C_VDD3; C_VDD4; C_BULK; 3.3V LINIAR REGULATOR; USB-C RECEPTACLE; ESD PROTECTION (Place by connector); SW_BOOT; SW_RST; MCU Support Circuits[1A], RC INPUT, STATUS LED, SWD HEADER[1C], STM32F446RET6 Core[3C]; NRST; C_LDO_OUT; SBU1; VBUS A4_B9 VBUS B4_A9; SBU2 B8 DN2 B7 DP2 B6 CC2 B5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

POWER OR-ING

BOOT/RESET (DFU Entery)
Hold BOOT, Tap RST, Release ->DFU

MCU Support Circuits[1A], STM32F446RET6 Core[3B] BOOT0

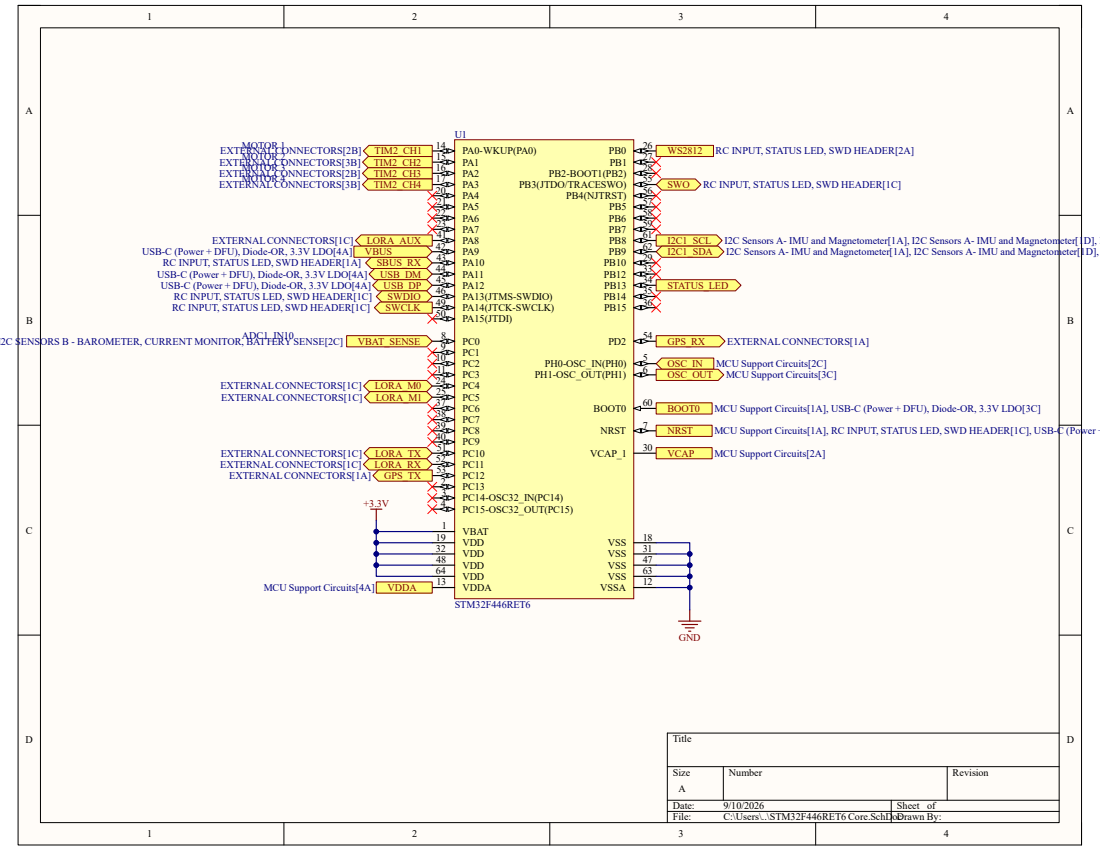
[picture p22: page 3]
Title; Size; Number; Revision; File:; C:\Users\..\STM32F446RET6 Core.SchDocDrawn By:; PA0-WKUP(PA0) 14 PA1 15 PA2 16 PA3 17; PB2-BOOT1(PB2); PC14-OSC32_IN(PC14) 3; PC15-OSC32_OUT(PC15) 4; PA8 41 PA9 42 PA10 43 PA11 44 PA12 45 PA13(JTMS-SWDIO) 46 PA14(JTCK-SWCLK) 49; PH0-OSC_IN(PH0); PA15(JTDI) 50; PB3(JTDO/TRACESWO); PB4(NJTRST); PH1-OSC_OUT(PH1); BOOT0; NRST; VBAT 1; VSSA; 12 VDDA 13; VSS; 18 VDD 19; VCAP_1; 31 VDD 32; 47 VDD 48; 63 VDD 64; STM32F446RET6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

WS2812 RC INPUT, STATUS LED, SWD HEADER[2A]

SWO RC INPUT, STATUS LED, SWD HEADER[1C]

I2C1_SCL I2C Sensors A- IMU and Magnetometer[1A], I2C Sensors A- IMU and Magnetometer[1D], I2C Sensors A- IMU and Magnetometer[3C], I2C SENSORS B - BAROMETER, CURRENT MONITOR, BATTERY SENSE[2A], I2C SENSORS B - BAROMETER, CURRENT MONITOR, BATTERY SENSE[4A]
I2C1_SDA I2C Sensors A- IMU and Magnetometer[1A], I2C Sensors A- IMU and Magnetometer[1D], I2C Sensors A- IMU and Magnetometer[3B], I2C SENSORS B - BAROMETER, CURRENT MONITOR, BATTERY SENSE[2A], I2C SENSORS B - BAROMETER, CURRENT MONITOR, BATTERY SENSE[4A]

USB-C (Power + DFU), Diode-OR, 3.3V LDO[4A] VBUS
USB-C (Power + DFU), Diode-OR, 3.3V LDO[4A] USB_DM
USB-C (Power + DFU), Diode-OR, 3.3V LDO[4A] USB_DP

OSC_IN MCU Support Circuits[2C]
OSC_OUT MCU Support Circuits[3C]

MCU Support Circuits[4A] VDDA

# RESET +3.3V1 2

# C_NRST ² ¹

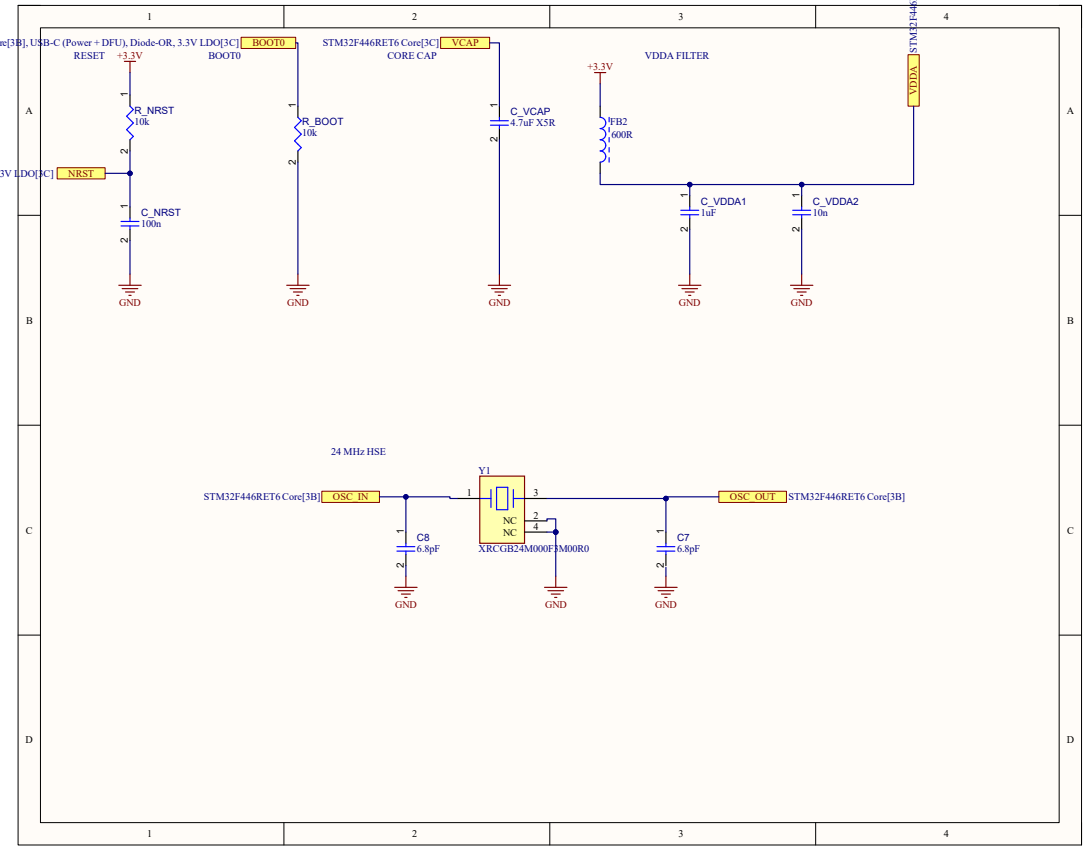
[picture p23: page 4]
R_NRST; NRST; GND; BOOT0; R_BOOT; CORE CAP; STM32F446RET6 Core[3C] VCAP 1 2; C_VCAP; VDDA FILTER; C_VDDA1; C_VDDA2; VDDA STM³²F⁴⁴⁶; XRCGB24M000F3M00R0; STM32F446RET6 Core[3B] OSC_IN; OSC_OUT STM32F446RET6 Core[3B] 1 2; 24 MHz HSE

STM32F446RET6 Core[3B], USB-C (Power + DFU), Diode-OR, 3.3V LDO[3C] BOOT0 2 1

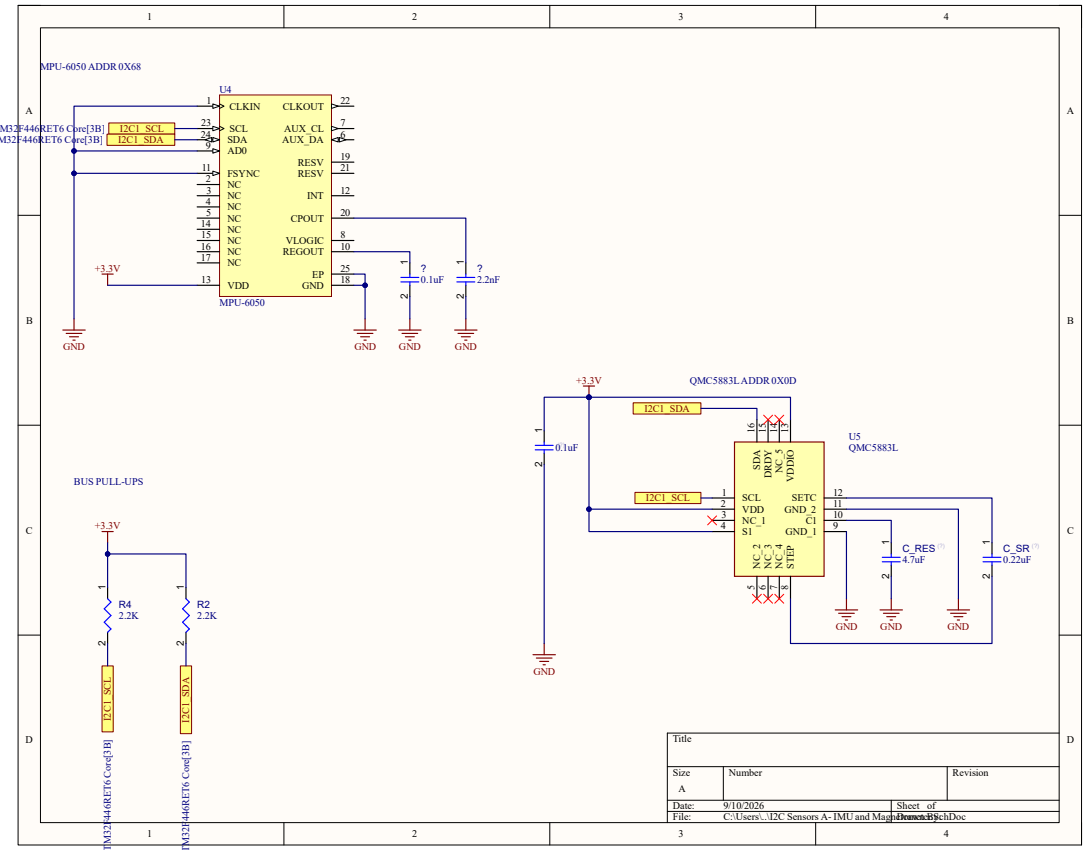
[picture p24: page 5]
Title; Size; Number; Revision; File:; C:\Users\..\I2C Sensors A- IMU and Magnetometer.SchDoc Drawn By:; SCL 1 VDD 2 NC_1 3; 6 NC_4 7 STEP; GND_1; 10 GND_2; 11 SETC; 12 VDDIO ¹³ NC_5 14 DRDY ¹⁵ SDA ¹⁶; U5 QMC5883L; QMC5883L ADDR 0X0D; CLKIN 1; AUX_DA; AUX_CL; VLOGIC; REGOUT; FSYNC 11; INT; VDD 13; GND; RESV; CPOUT; CLKOUT; SCL 23 SDA 24; MPU-6050; MPU-6050 ADDR 0X68; I2C1_SCL I2C1_SDA; I2C1_SCL; I2C1_SDA; C_RES ⁽?); GND 1 2

BUS PULL-UPS
R2 I2C¹_SDA TM³²F⁴⁴⁶RET⁶ Core[3B] I2C¹_SCL TM³²F⁴⁴⁶RET⁶ Core[3B]

+3.3V1 2

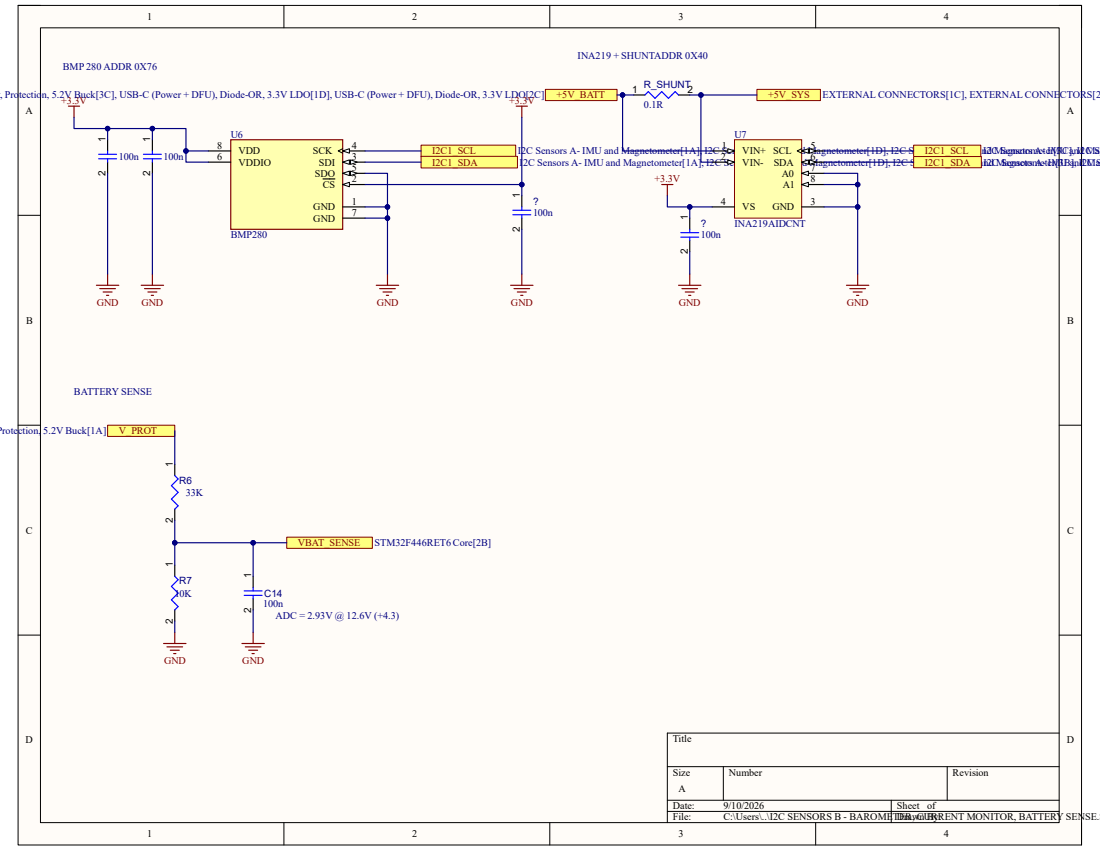
[picture p25: page 6]
Title; Size; Number; Revision; File:; C:\Users\..\I2C SENSORS B - BAROMETER, CURRENT MONITOR, BATTERY SENSE.SchDoc Drawn By:; VDD 8 VDDIO 6; SCK; SDI; SDO; GND; BMP280; BMP 280 ADDR 0X76; I2C1_SCL; I2C Sensors A- IMU and Magnetometer[1A], I2C Sensors A- IMU and Magnetometer[1D], I2C Sensors A- IMU and Magnetometer[3C], I2C SENSORS B - BAROMETER, CURRENT MONITOR, BATTERY SENSE[4A], STM32F446RET6 Core[3B]; I2C1_SDA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

I2C1_SDA I2C Sensors A- IMU and Magnetometer[1A], I2C Sensors A- IMU and Magnetometer[1D], I2C Sensors A- IMU and Magnetometer[3B], I2C SENSORS B - BAROMETER, CURRENT MONITOR, BATTERY SENSE[2A], STM32F446RET6 Core[3B] 1 2

1 2 3

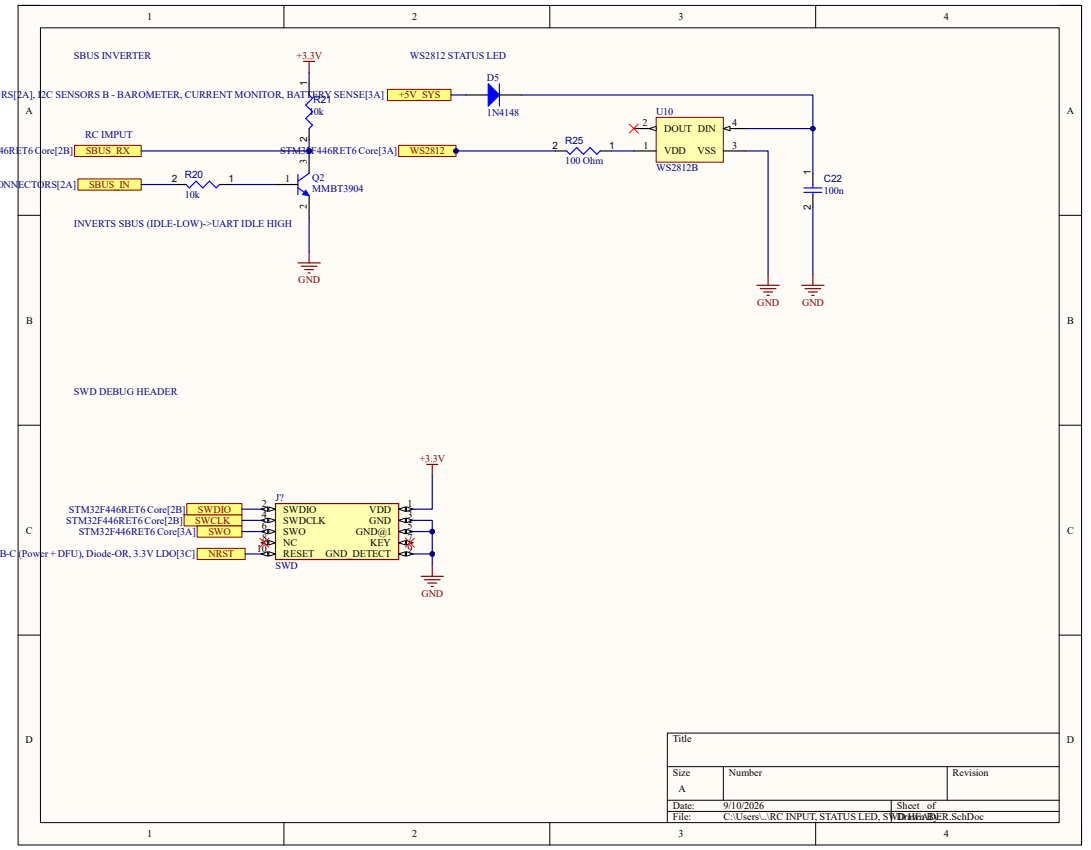
[picture p26: page 7]
Title; Size; Number; Revision; File:; C:\Users\..\RC INPUT, STATUS LED, SWD HEADER.SchDoc Drawn By:; MMBT3904 ² ¹ 10k R21; GND; SBUS_IN; SBUS_RX; RC IMPUT; SBUS INVERTER; VDD 1; DOUT 2; VSS; DIN; +5V_SYS; STM32F446RET6 Core[3A] WS2812; 100 Ohm; SWDIO 2 SWDCLK 4 SWO 6 NC 8 RESET 10; VDD; GND@1; KEY; GND_DETECT; SWD; STM32F446RET6 Core[2B] SWCLK; STM32F446RET6 Core[2B] SWDIO; NRST; WS2812 STATUS LED; STM32F446RET6 Core[3A] SWO

INVERTS SBUS (IDLE-LOW)->UART IDLE HIGH

SWD DEBUG HEADER

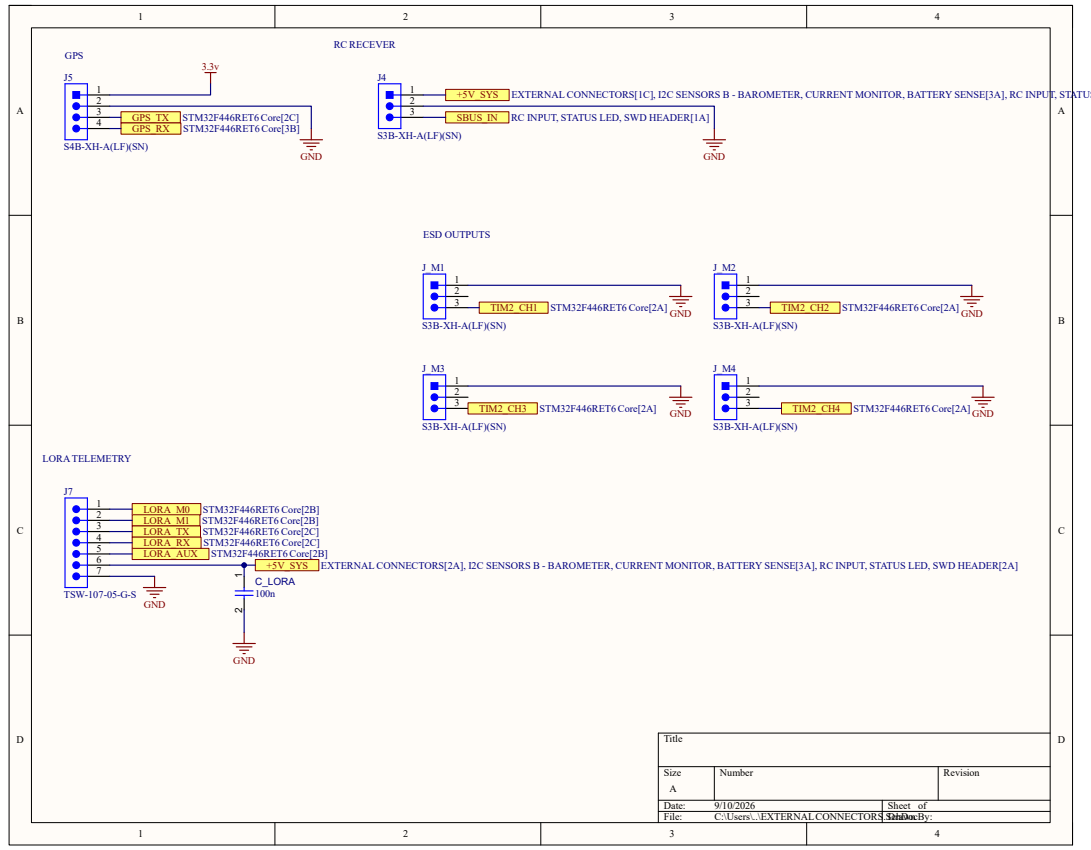
[picture p27: page 8]
Title; Size; Number; Revision; File:; C:\Users\..\EXTERNAL CONNECTORS.SchDoc Drawn By:; GPS_TX STM32F446RET6 Core[2C] GPS_RX STM32F446RET6 Core[3B]; GND; GPS; RC RECEVER; TIM2_CH1 STM32F446RET6 Core[2A]; TIM2_CH3 STM32F446RET6 Core[2A]; TIM2_CH4 STM32F446RET6 Core[2A]; TIM2_CH2 STM32F446RET6 Core[2A]; TSW-107-05-G-S; LORA_AUX STM32F446RET6 Core[2B]; LORA_M0 STM32F446RET6 Core[2B] LORA_M1 STM32F446RET6 Core[2B] LORA_TX STM32F446RET6 Core[2C] LORA_RX STM32F446RET6 Core[2C]; LORA TELEMETRY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

+5V_SYS EXTERNAL CONNECTORS[1C], I2C SENSORS B - BAROMETER, CURRENT MONITOR, BATTERY SENSE[3A], RC INPUT, STATUS LED, SWD HEADER[2A]

SBUS_IN RC INPUT, STATUS LED, SWD HEADER[1A]

+5V_SYS EXTERNAL CONNECTORS[2A], I2C SENSORS B - BAROMETER, CURRENT MONITOR, BATTERY SENSE[3A], RC INPUT, STATUS LED, SWD HEADER[2A]
C_LORA
