Khalil-ee/MK.2-Flight-Controller/Altium/Schematic v2/Schematic v2.pdf

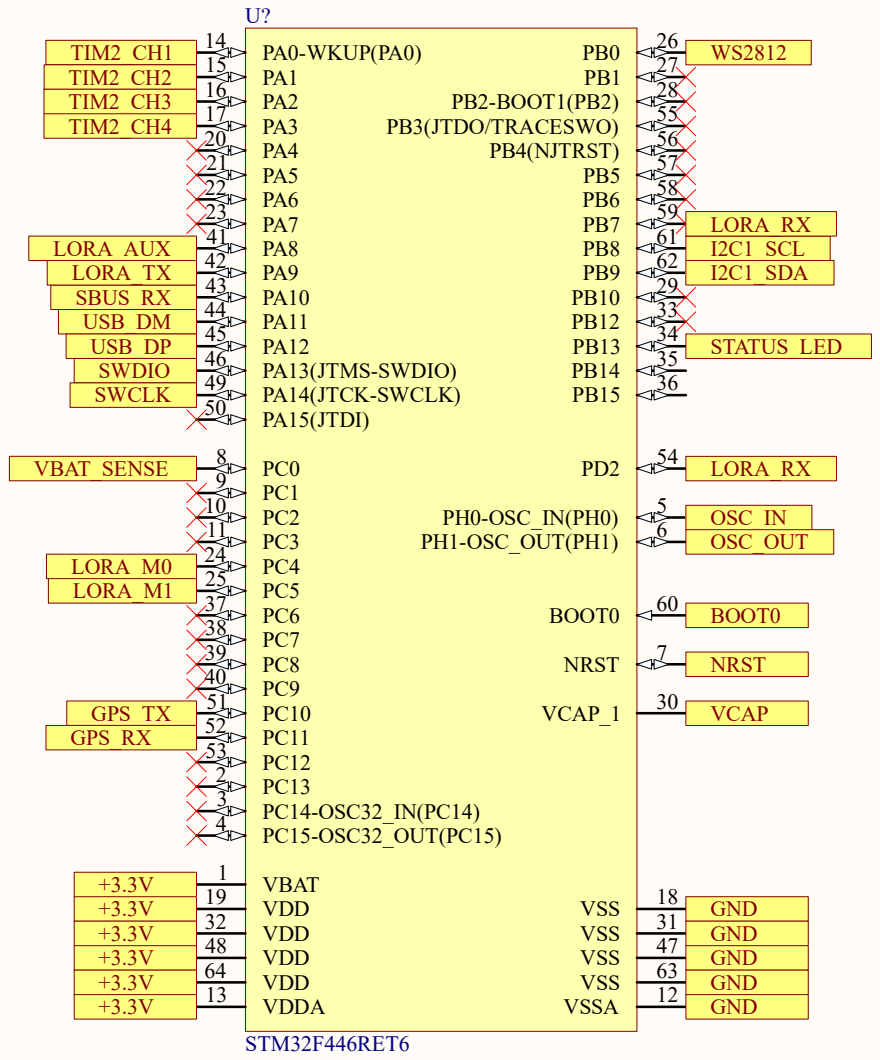
[picture p28: page 1]
Title; Size; Number; Revision A; Date:; Sheet of; File:; C:\Users\..\MCU Core(OLD).SchDoc; Drawn By:; PA0-WKUP(PA0) 14 PA1 15 PA2 16 PA3 17; PB2-BOOT1(PB2); PC14-OSC32_IN(PC14); PC15-OSC32_OUT(PC15); PA8 41 PA9 42 PA10 43 PA11 44 PA12 45 PA13(JTMS-SWDIO) 46 PA14(JTCK-SWCLK) 49; PH0-OSC_IN(PH0); PA15(JTDI) 50; PB3(JTDO/TRACESWO); PB4(NJTRST); PH1-OSC_OUT(PH1); BOOT0; NRST; VBAT; VSSA; 12 VDDA 13; VSS; 18 VDD 19; VCAP_1; 31 VDD 32; 47 VDD 48; 63 VDD 64; STM32F446RET6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

+3.3V VDD | VSS | VCAP¹ | VCAP²

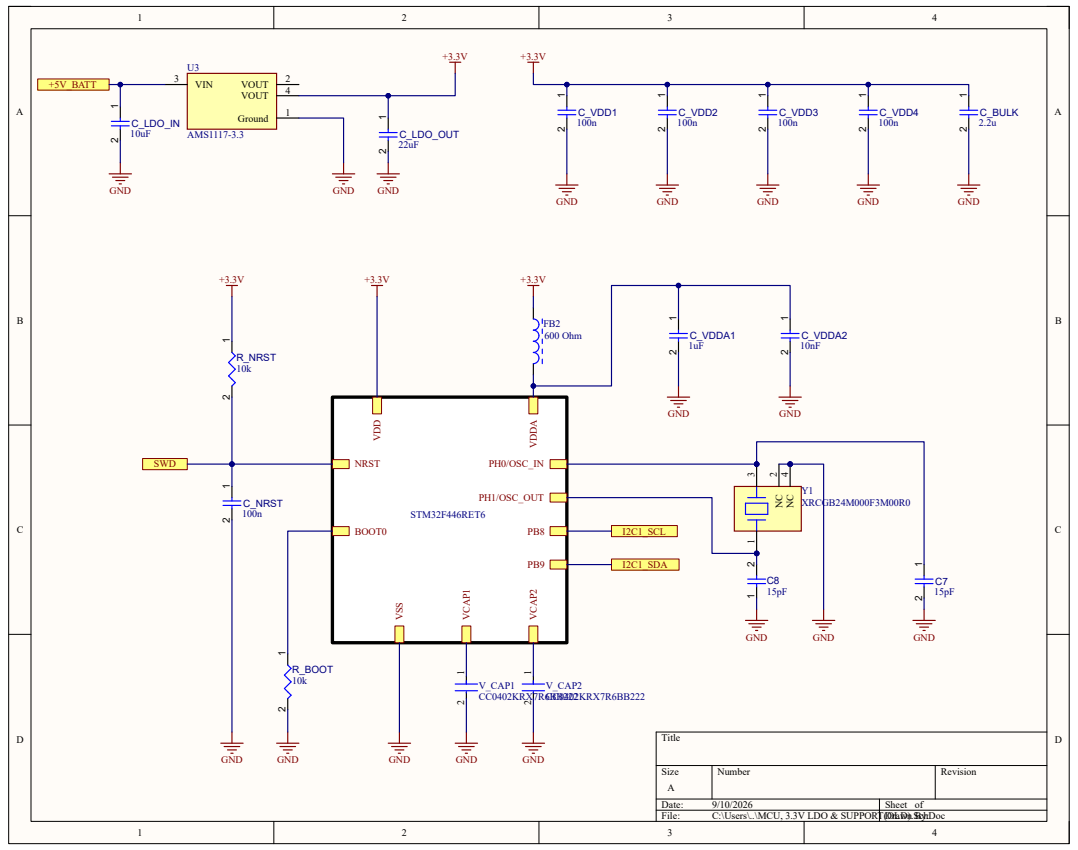
[picture p29: page 2]
Title; Size; Number; Revision; File:; C:\Users\..\MCU, 3.3V LDO & SUPPORT(OLD).SchDoc Drawn By:; VIN 3; VOUT; Ground; AMS1117-3.3; GND; +5V_BATT 1 2; C_LDO_IN; C_LDO_OUT; BOOT0; NRST; VDDA; PH0/OSC_IN; PH1/OSC_OUT; STM32F446RET6; I2C1_SCL; I2C1_SDA; 600 Ohm; R_BOOT; C_NRST; SWD; R_NRST; C_VDD1; C_VDD2; C_VDD3; C_VDD4; C_BULK; GND 1 2; C_VDDA1; C_VDDA2; V_CAP1; CC0402KRX7R6BB222 ¹ 2 V_CAP2 CC0402KRX7R6BB222; Y1 XRCGB24M000F3M00R0; GND ¹ ²

1 2 3

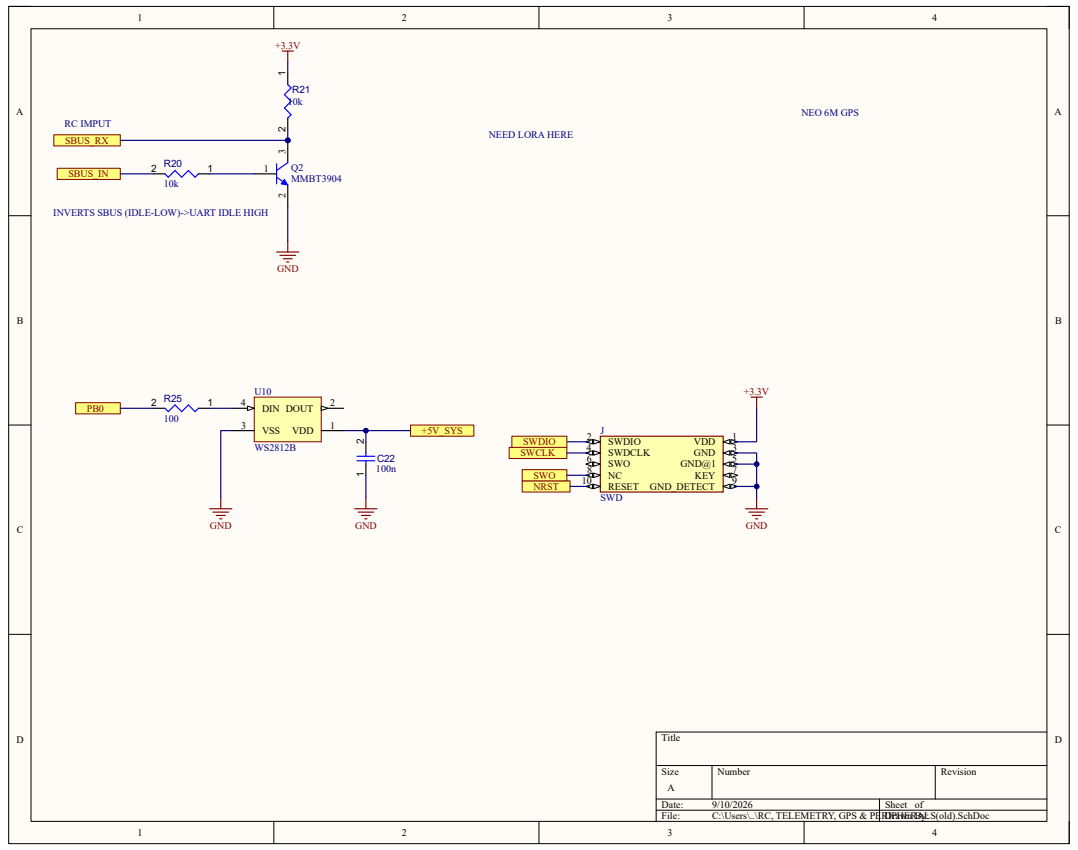
[picture p30: page 3]
Title; Size; Number; Revision; File:; C:\Users\..\RC, TELEMETRY, GPS & PERIPHERALS(old).SchDoc Drawn By:; MMBT3904 ² ¹ 10k R21; GND; SBUS_IN; SBUS_RX; RC IMPUT; VDD; DOUT; VSS 3; DIN 4; +5V_SYS; NEO 6M GPS; SWDIO 2 SWDCLK 4 SWO 6 NC 8 RESET 10; GND@1; KEY; GND_DETECT; SWD; SWCLK; SWDIO; NRST; SWO

NEED LORA HERE

INVERTS SBUS (IDLE-LOW)->UART IDLE HIGH

R4 2 1 2.2k

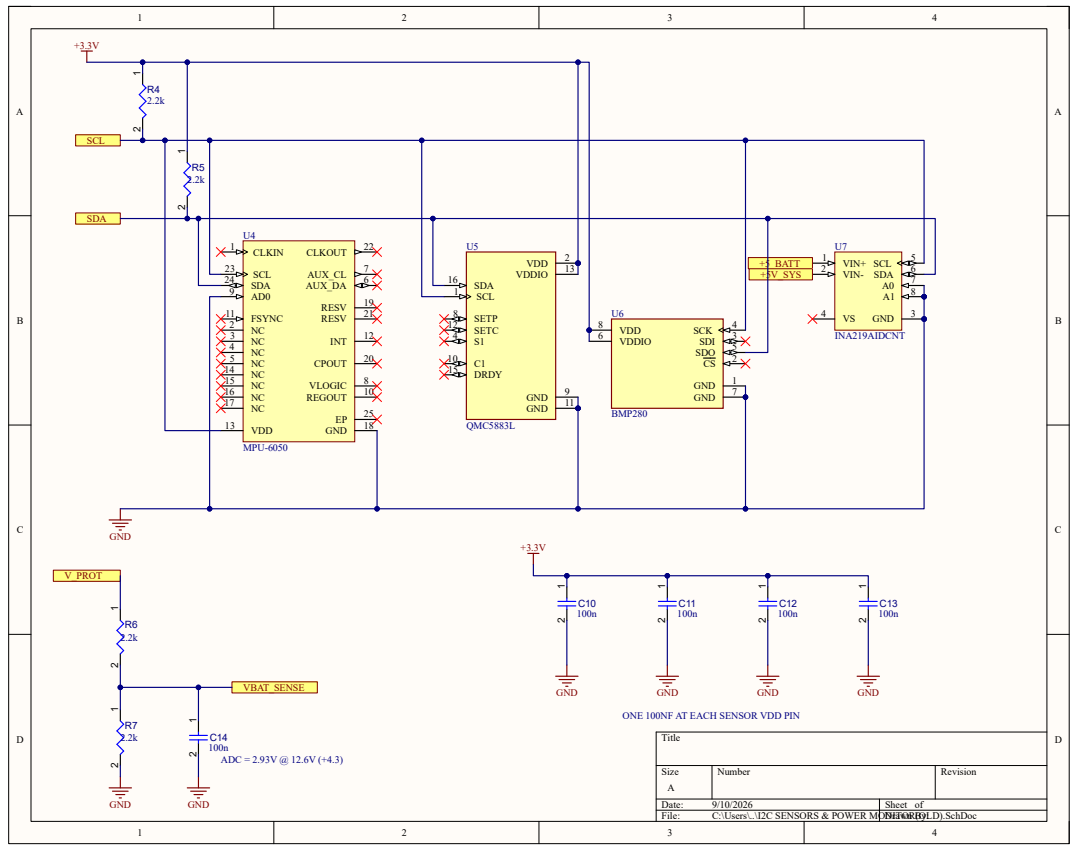
[picture p31: page 4]

ONE 100NF AT EACH SENSOR VDD PIN ² ¹ 2.2k
