Khalil-ee/MK.2-Flight-Controller/(list of files, drawings)

Other design files:
Altium/Schematic v1/Schematic v1.SchDoc
Altium/Schematic v2/I2C SENSORS & POWER MONITOR.SchDoc
Altium/Schematic v2/MCU Core.SchDoc
Altium/Schematic v2/MCU, 3.3V LDO & SUPPORT.SchDoc
Altium/Schematic v2/RC, TELEMETRY, GPS & PERIPHERALS.SchDoc
Altium/Schematic v3/Schematic v3.PrjPcb
