Khalil-ee/MK.2-Flight-Controller/(commit log)

2026-04-16 Document Nucleo Cubemx setup process for IDE
    Added detailed steps for setting up Nucleo Cubemx with STM32CubeIDE.
2026-04-18 Add update for IMU code creation on 4/17/26
    Added entry for successful creation of IMU code that reads data and connects to the Nucleo board.
2026-04-18 Created Sensors folder and inserted MPU6050 code
2026-04-18 Create IMU (MPU-6050)
2026-04-18 Add README for STM32 IMU Test Project
    This README provides an overview of the STM32 IMU test project, detailing its purpose, hardware requirements, wiring, peripherals used, code functionality, variable explanations, expected output, current results, and instructions for running the project.
2026-04-23 Add README for STM32 BMP180 Pressure Sensor Test
    Added detailed project overview, hardware, software, pin connections, and configuration settings for the BMP180 sensor test with STM32.
2026-04-23 Enhance BMP180 README with formatting and details
    Updated README.md for BMP180 sensor to improve clarity and formatting.
2026-04-24 Add updates for BMP180 and magnometer sensor work
2026-04-24 Add entry for received third Nucleo board
2026-04-24 Add entry for ordered INA219 voltage/current sensors
2026-04-30 Update INA-219.zip
    Added INA219 sensor project documentation and files.
2026-04-30 Add INA219 sensor project for STM32 Nucleo
    Added a bare-metal STM32 HAL project for the INA219 sensor, including wiring, CubeMX configuration, and build instructions.
2026-05-04 Add entry for prototype board build on 5/4/26
2026-05-05 Add entry for sensor fusion completion
2026-05-10 Update power circuit and add MPU-6050 schematic details
2026-05-14 Add BMP-180 schematic completion date
2026-05-25 Add entry for completed MPU schematic
2026-06-22 Add design change for battery telemetry
2026-06-28 Add updates for MCU wiring and battery circuit
2026-07-02 Update input/power circuit design details
    Redesigned the input/power circuit to include a missing bypass capacitor and updated component values.
2026-07-03 Document design updates and circuit progress
    Added updates for completed design in Altium and progress on RC, telemetry, GPS, and peripherals circuit.
2026-07-19 Add new update for connector additions
2026-08-22 Add update for reworked USB-C and power supply circuit
2026-09-10 Document recent project updates and circuit schematics
    Added updates for circuit schematics and project reports.
2026-09-10 Create Schematic v3
2026-09-16 Update circuit v3 status from verification to validation
2026-09-16 Add files via upload
    Madgwick sensor fusion algorithm for prototype board
2026-09-24 Add files via upload
    Updated schematic that is cleaned up and passes ERC
2026-09-24 Fix typo and update schematic entry in Updates.txt
2026-09-24 Fix formatting in Updates.txt for schematic update
2026-09-24 Fix typo in schematic update entry
2026-10-13 Add files via upload
    Schematic send to PCB way for production.
2026-10-13 Add entry for schematic sent to PCBway
2026-10-27 Create Gerber Files
